vagarthgaurav/NanoPage/Case/previews/closed_back.png

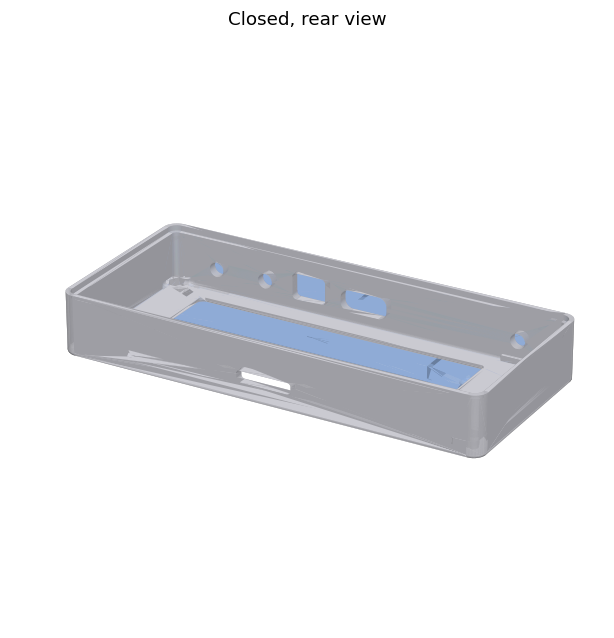
Case/previews/closed_back.png
