vagarthgaurav/NanoPage/Case/previews/closed_front.png

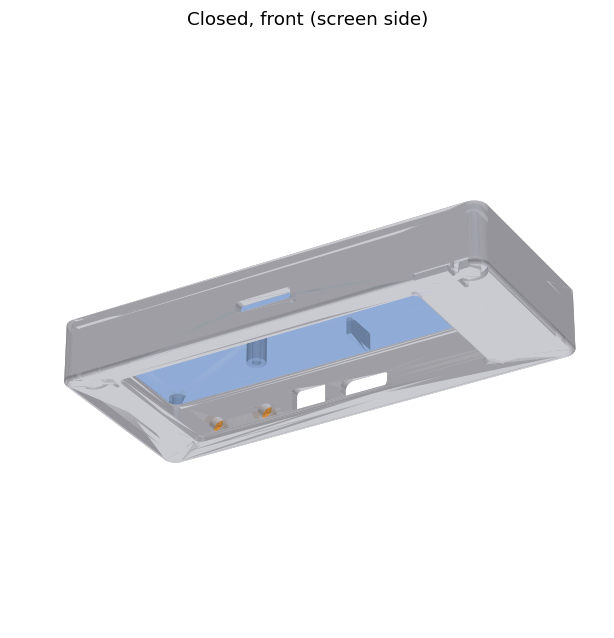
Case/previews/closed_front.png
