vagarthgaurav/NanoPage/Case/previews/inside.png

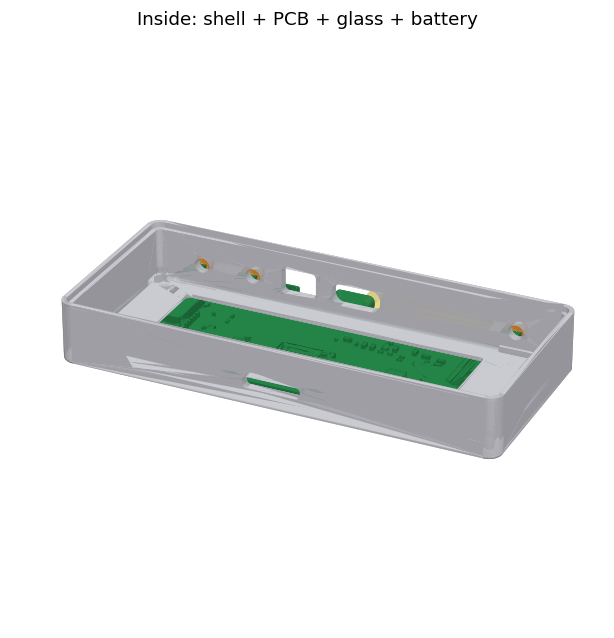
Case/previews/inside.png
