vagarthgaurav/NanoPage/Case/previews/shell_back.png

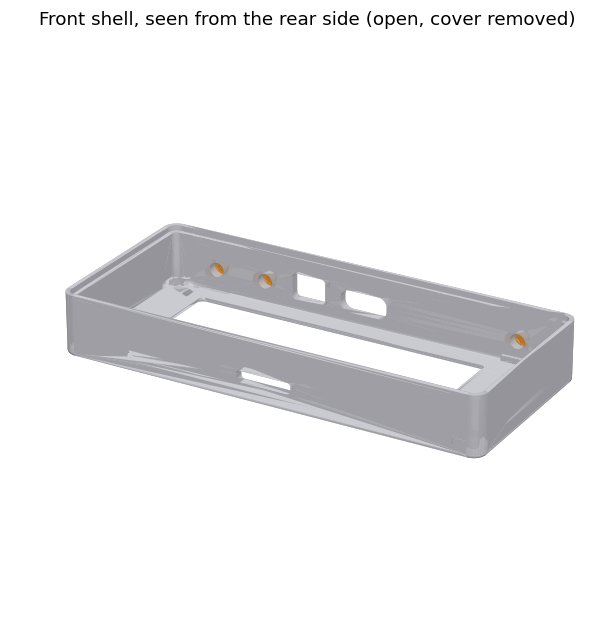
Case/previews/shell_back.png
