vagarthgaurav/NanoPage/Hardware/NanoPage/NanoPage.png

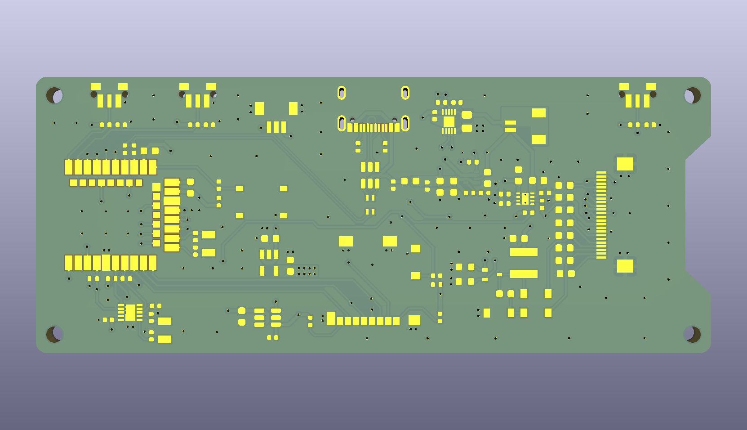
Hardware/NanoPage/NanoPage.png
