vagarthgaurav/NanoPage/Case/ref/nanopage_full.step

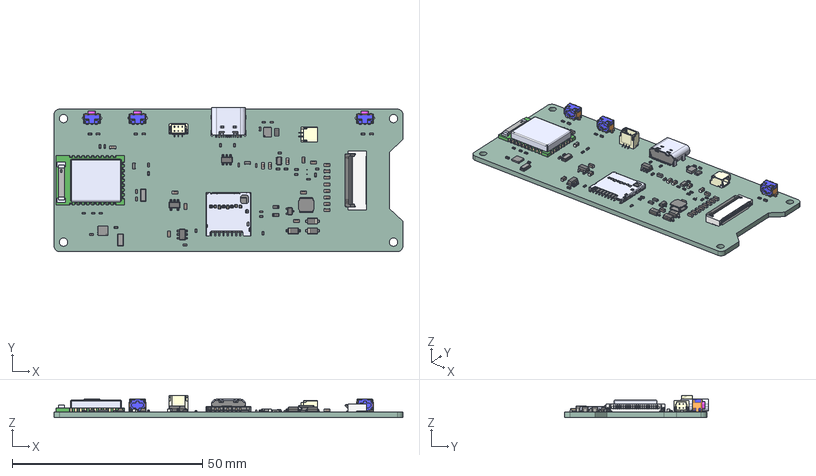
[picture p6: CAD file, 2026-10-15]
Case/ref/nanopage_full.step
91.8 x 38.0 x 5.90 mm
R_0402_1005Metric x 24
C_0402_1005Metric x 13
Crystal_SMD_3215-2Pin_3.2x1.5mm x 2
C_0603_1608Metric x 19
R_0805_2012Metric
E73-2G4M08S1C
D_SOD-123 x 3
ThermalPin x 2
PinsArrayLR x 2
FPC-05FB-24PH20
SM02B-SRSS-TB(LF)(SN)
SOT-323_SC-70
BM03B-SRSS-TB(LF)(SN)
NR4018
SOT-23-6 x 2
TPS2116DRLR
L_0603_1608Metric x 2
R_0603_1608Metric x 2
SOT-23-5
TYPE-C-31-M-12
NanoPage_PCB
