vagarthgaurav/NanoPage/Case/out/front_shell.step

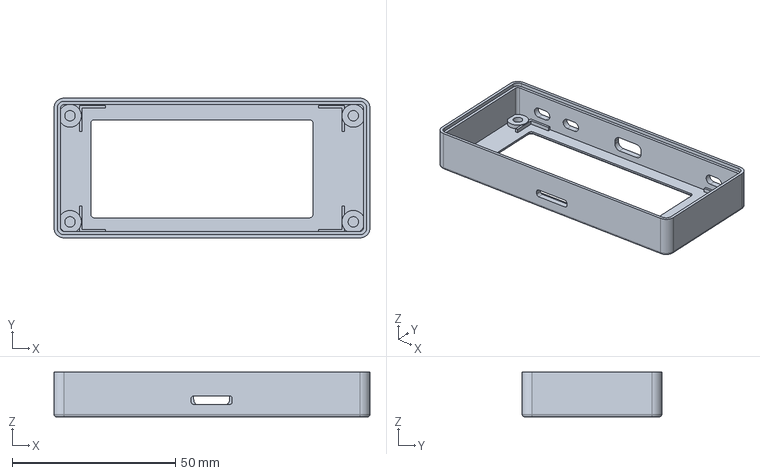
[picture p7: CAD file, 2026-10-15]
Case/out/front_shell.step
96.8 x 42.8 x 13.8 mm
