vagarthgaurav/NanoPage/Case/out/rear_cover.step

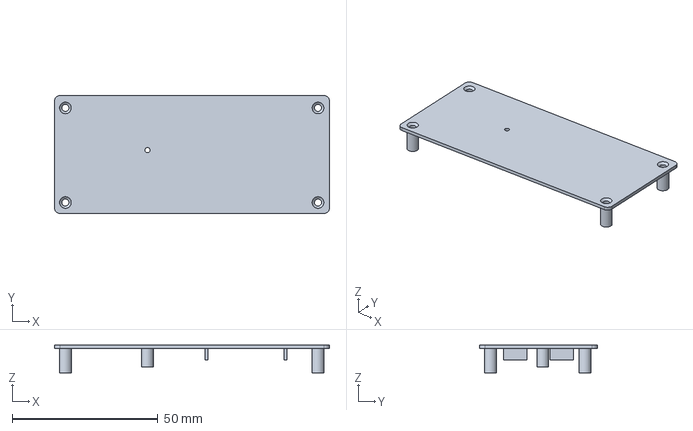
[picture p8: CAD file, 2026-10-15]
Case/out/rear_cover.step
94.5 x 40.5 x 9.53 mm
