vagarthgaurav/NanoPage/Case/out/button_cap.step

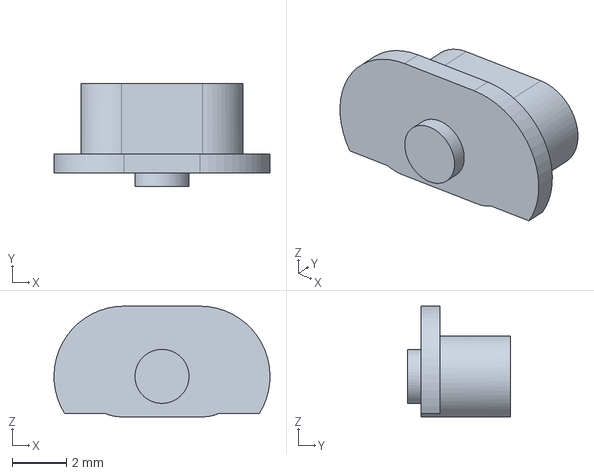
[picture p9: CAD file, 2026-10-15]
Case/out/button_cap.step
8.00 x 3.80 x 4.10 mm
