vagarthgaurav/NanoPage/Case/out/NanoPage_case.FCStd

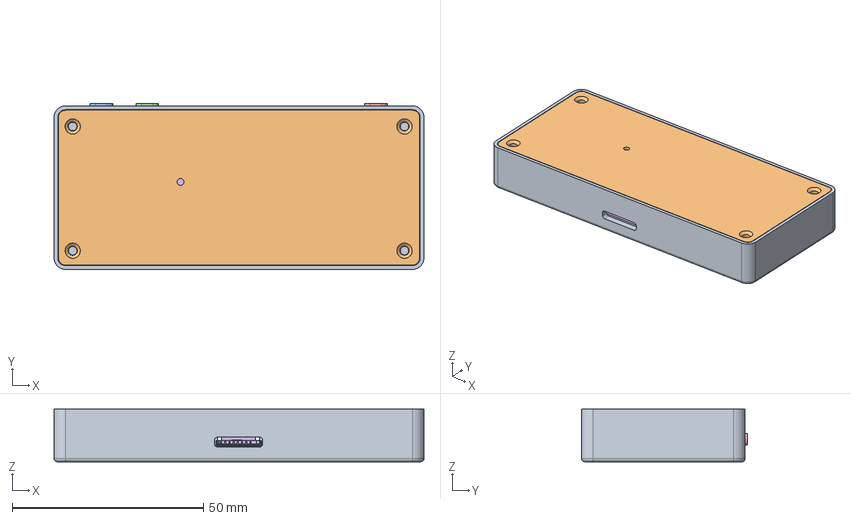
[picture p10: CAD file, 2026-10-15]
Case/out/NanoPage_case.FCStd
96.8 x 43.4 x 13.8 mm
front_shell
rear_cover
button_cap_1
button_cap_2
button_cap_3
ghost_PCB_assembly
ghost_display_glass
ghost_battery_box
ghost_FPC_corridor
