vagarthgaurav/NanoPage/(list of files, cad)

Other CAD files:
Case/out/button_cap.stl
Case/out/front_shell.stl
Case/out/rear_cover.stl
