vagarthgaurav/NanoPage/Hardware/NanoPage/NanoPage.kicad_pcb

## KiCad design Hardware/NanoPage/NanoPage.kicad_pcb (2026-10-14)

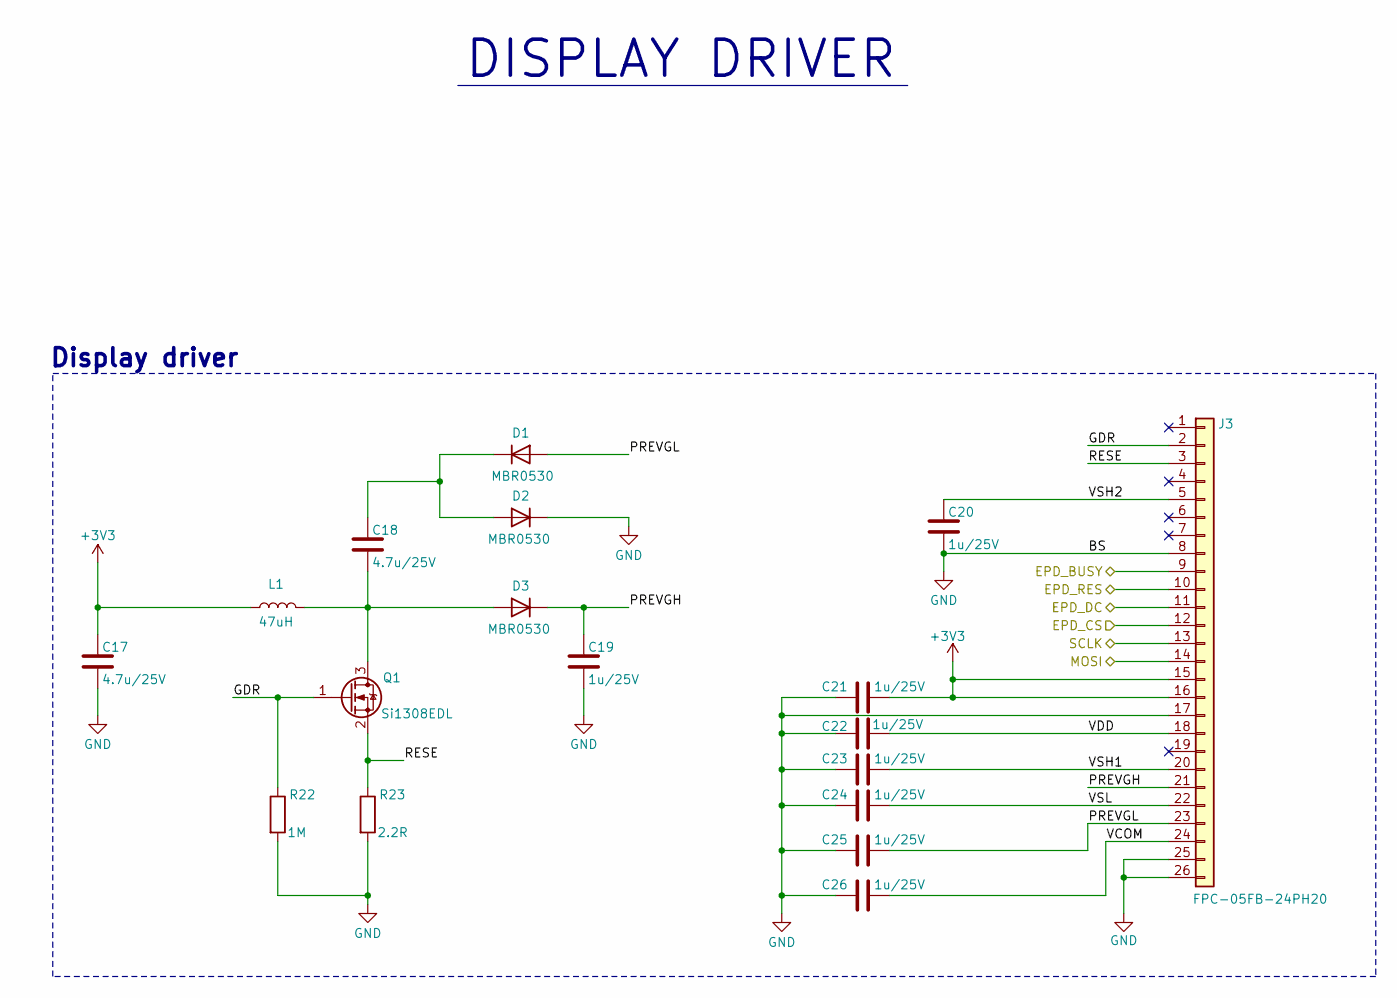
[picture p11: schematic display.kicad_sch]

Parts:
C17, C18: 4.7u/25V; C_0603_1608Metric
C19, C20, C21, C22, C23, C24, C25, C26: 1u/25V; C_0603_1608Metric
D1, D2, D3: MBR0530; D_SOD-123
J3: FPC-05FB-24PH20; XUNPU FPC-05FB-24PH20
L1: 47uH; NR4018
Q1: Si1308EDL; SOT-323_SC-70
R22: 1M; R_0603_1608Metric
R23: 2.2R; R_0603_1608Metric

Connections:
+3V3: C17.1, C21.2, J3.15, J3.16, L1.1; also elsewhere on the board
/Display/EPD_BUSY: J3.9; also elsewhere on the board
/Display/EPD_CS: J3.12; also elsewhere on the board
/Display/EPD_DC: J3.11; also elsewhere on the board
/Display/EPD_RES: J3.10; also elsewhere on the board
/Display/GDR: J3.2, Q1.1 (G), R22.1
/Display/MOSI: J3.14; also elsewhere on the board
/Display/PREVGH: C19.1, D3.1 (K), J3.21
/Display/PREVGL: C25.2, D1.2 (A), J3.23
/Display/RESE: J3.3, Q1.2 (S), R23.1
/Display/SCLK: J3.13; also elsewhere on the board
/Display/VCOM: C26.2, J3.24
/Display/VDD: C22.2, J3.18
/Display/VSH1: C23.2, J3.20
/Display/VSH2: C20.1, J3.5
/Display/VSL: C24.2, J3.22
GND: C17.2, C19.2, C20.2, C21.1, C22.1, C23.1, C24.1, C25.1, C26.1, D2.1 (K), J3.8, J3.17, J3.25, J3.26, R22.2, R23.2; also elsewhere on the board
unnamed: C18.1, D1.1 (K), D2.2 (A)
unnamed: C18.2, D3.2 (A), L1.2, Q1.3 (D)

Notes on the sheet:
Display driver
DISPLAY DRIVER

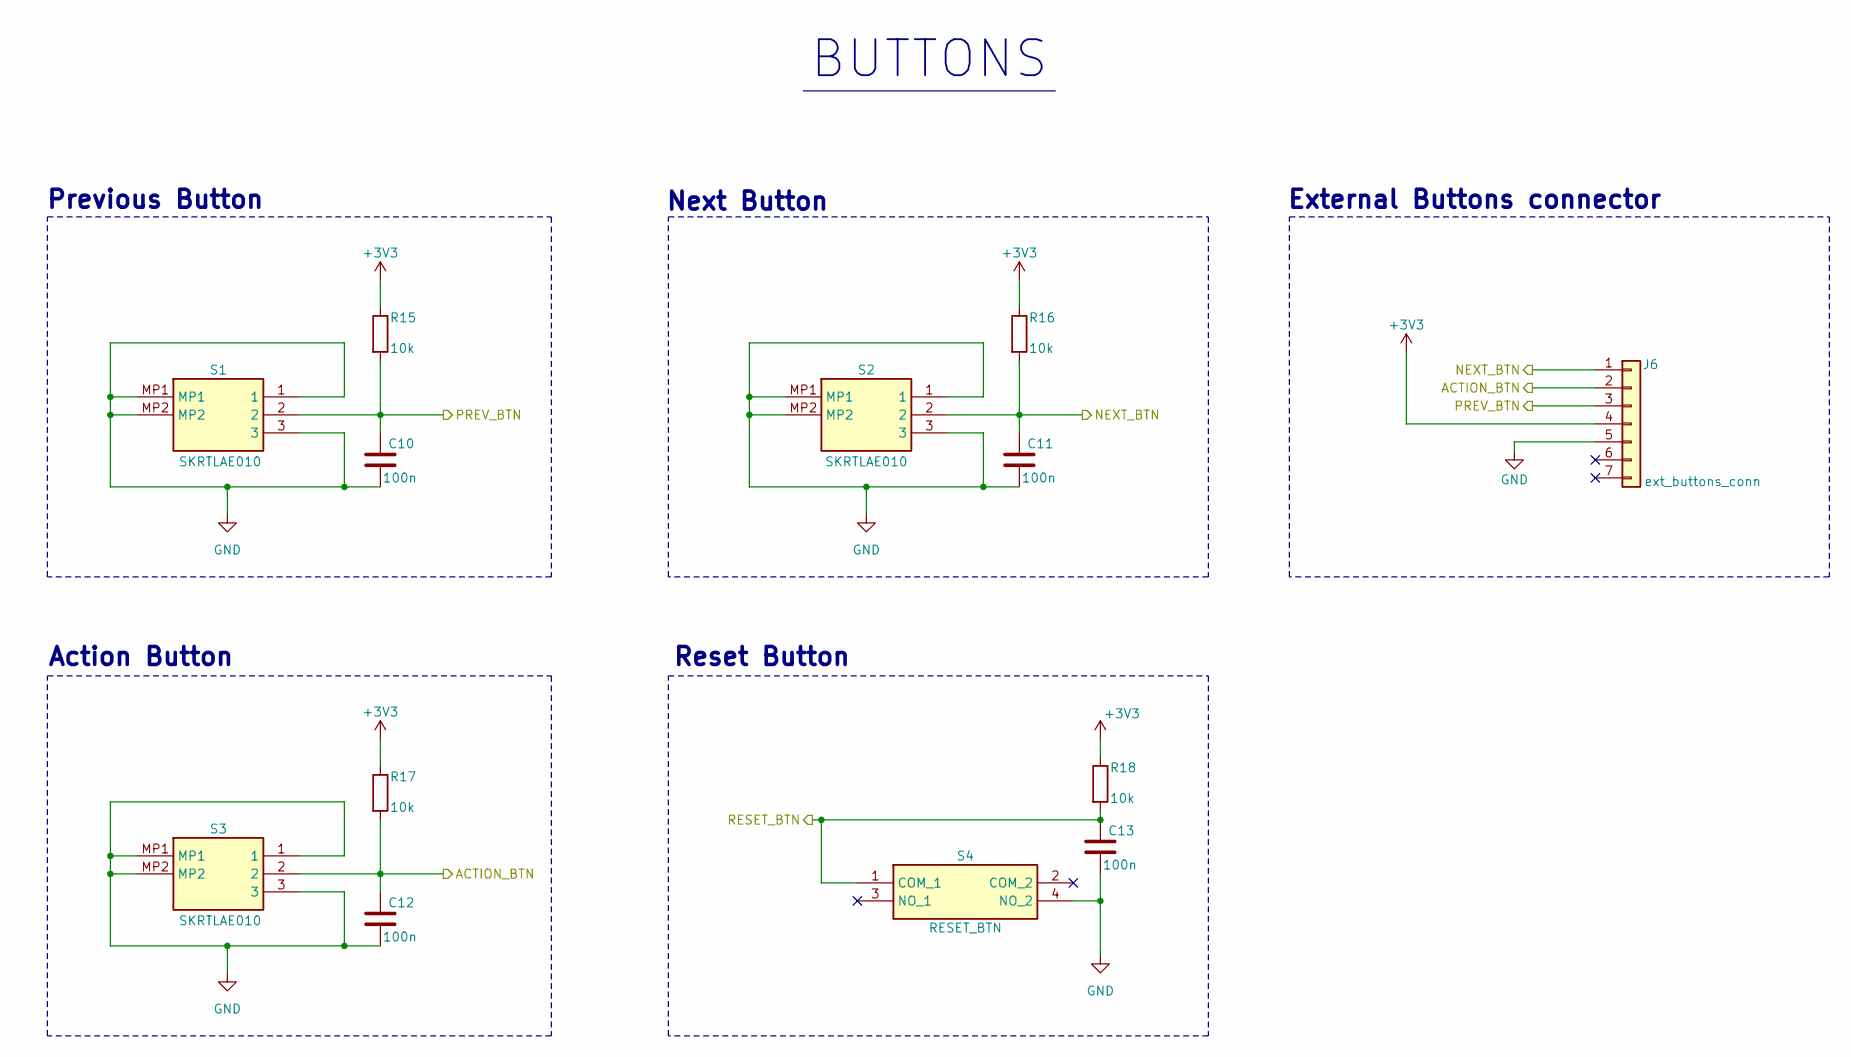
[picture p12: schematic buttons.kicad_sch]

Parts:
C10, C11, C12, C13: 100n; C_0402_1005Metric
J6: ext_buttons_conn; HC-FPC-05-09-5RLTAG
R15, R16, R17, R18: 10k; R_0402_1005Metric
S1, S2, S3: SKRTLAE010; Mouser Part Number 688-SKRTLA
S4: RESET_BTN; PTS526SM15SMTR2LFS; Mouser Part Number 611-PTS526SM15SMTR2L

Connections:
+3V3: J6.4, R15.1, R16.1, R17.1, R18.1; also elsewhere on the board
/Buttons/ACTION_BTN: C12.1, J6.2, R17.2, S3.2; also elsewhere on the board
/Buttons/NEXT_BTN: C11.1, J6.1, R16.2, S2.2; also elsewhere on the board
/Buttons/PREV_BTN: C10.1, J6.3, R15.2, S1.2; also elsewhere on the board
/Buttons/RESET_BTN: C13.1, R18.2, S4.1 (COM_1); also elsewhere on the board
GND: C10.2, C11.2, C12.2, C13.2, J6.5, S1.1, S1.3, S1.MP1, S1.MP2, S2.1, S2.3, S2.MP1, S2.MP2, S3.1, S3.3, S3.MP1, S3.MP2, S4.4 (NO_2); also elsewhere on the board

Notes on the sheet:
External Buttons connector
Reset Button
Action Button
BUTTONS
Next Button
Previous Button

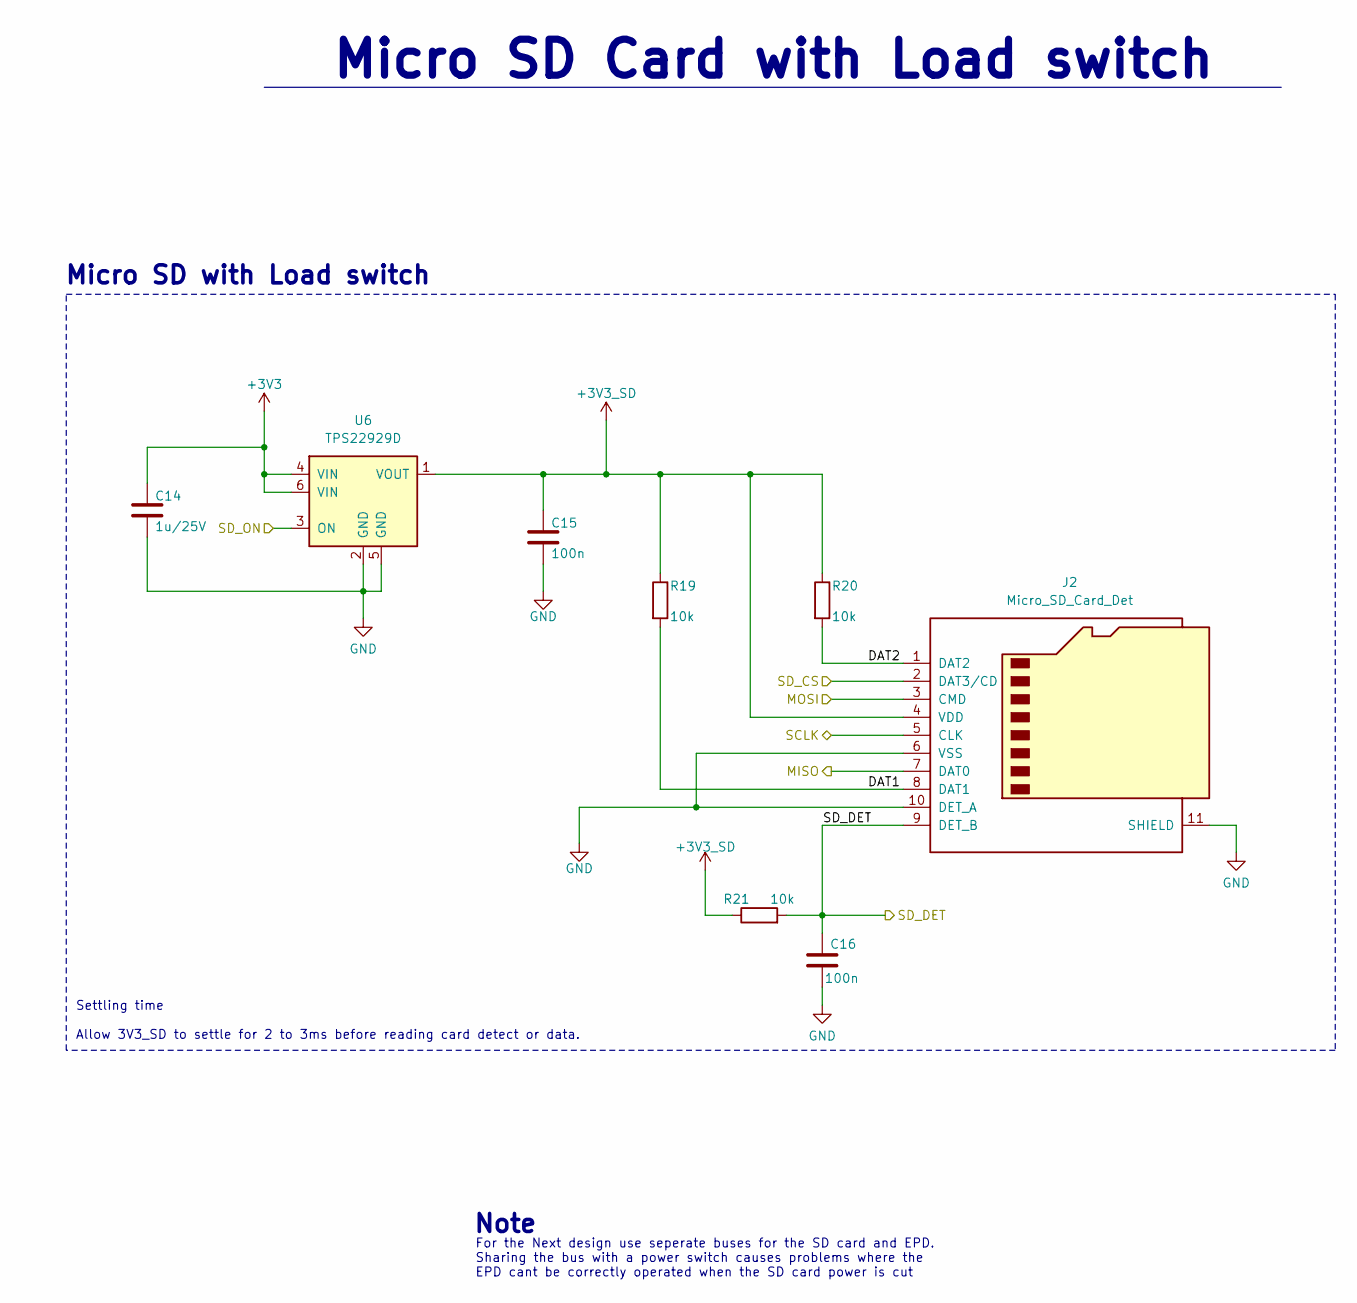
[picture p13: schematic sd_card.kicad_sch]

Parts:
C14: 1u/25V; C_0603_1608Metric
C15, C16: 100n; C_0402_1005Metric
J2: Micro_SD_Card_Det; microSD_HC_Molex_104031-0811
R19, R20, R21: 10k; R_0402_1005Metric
U6: TPS22929D; SOT-23-6

Connections:
+3V3: C14.1, U6.4 (VIN), U6.6 (VIN); also elsewhere on the board
+3V3_SD: C15.1, J2.4 (VDD), R19.1, R20.1, R21.1, U6.1 (VOUT)
/Display/MOSI: J2.3 (CMD); also elsewhere on the board
/Display/SCLK: J2.5 (CLK); also elsewhere on the board
/Microcontroller/MCU_SD_CS: J2.2 (DAT3/CD); also elsewhere on the board
/Microcontroller/MCU_SD_ON: U6.3 (ON); also elsewhere on the board
/Microcontroller/MISO: J2.7 (DAT0); also elsewhere on the board
/SD Card/DAT1: J2.8 (DAT1), R19.2
/SD Card/DAT2: J2.1 (DAT2), R20.2
/SD Card/SD_DET: C16.1, J2.9 (DET_B), R21.2; also elsewhere on the board
GND: C14.2, C15.2, C16.2, J2.6 (VSS), J2.10 (DET_A), J2.11 (SHIELD), U6.2 (GND), U6.5 (GND); also elsewhere on the board

Notes on the sheet:
Settling time Allow 3V3_SD to settle for 2 to 3ms before reading card detect or data.
For the Next design use seperate buses for the SD card and EPD. Sharing the bus with a power switch causes problems where the EPD cant be correctly operated when the SD card power is cut
Micro SD Card with Load switch
Note
Micro SD with Load switch

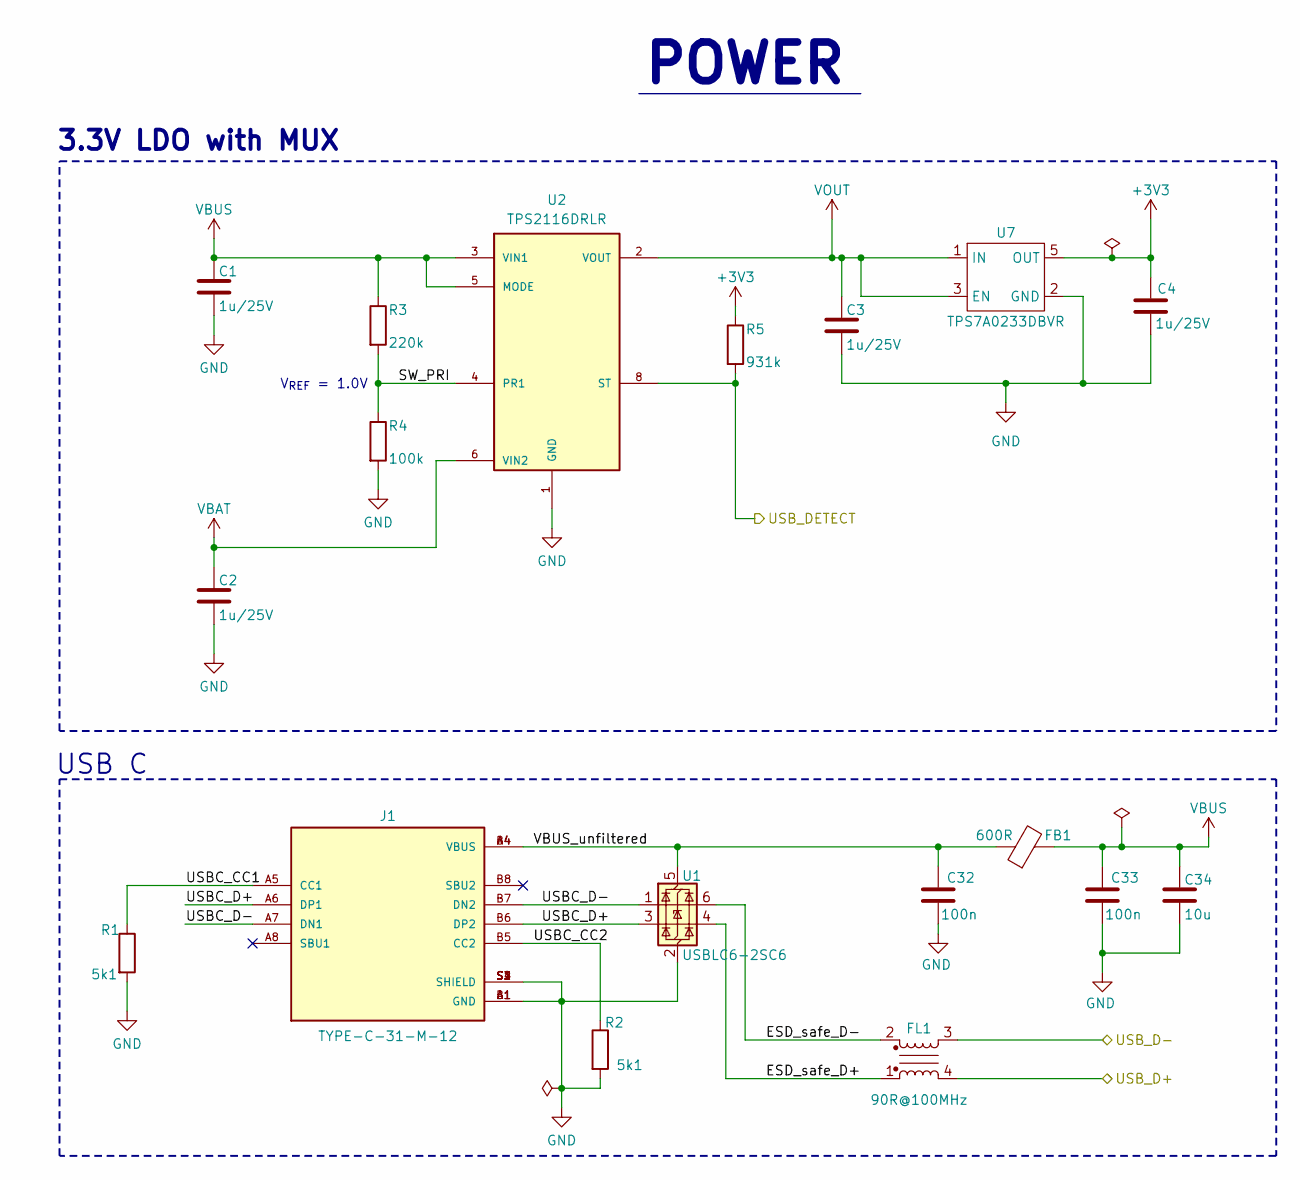
[picture p14: schematic power.kicad_sch]

Parts:
C1, C2, C3, C4: 1u/25V; C_0603_1608Metric
C32, C33: 100n; C_0402_1005Metric
C34: 10u; C_0603_1608Metric
FB1: 600R; L_0603_1608Metric
FL1: 90R@100MHz; L_CommonModeChoke_TDK_0503USB
J1: TYPE-C-31-M-12; HRO_TYPE-C-31-M-12; PARTREV 2020.12.08
R1, R2: 5k1; R_0402_1005Metric
R3: 220k; R_0402_1005Metric
R4: 100k; R_0402_1005Metric
R5: 931k; R_0402_1005Metric
U1: USBLC6-2SC6; SOT-23-6
U2: TPS2116DRLR; SOTFL50P160X60-8N; PARTREV A
U7: TPS7A0233DBVR; SOT-23-5

Connections:
+3V3: C4.1, R5.1, U7.5 (OUT); also elsewhere on the board
/Microcontroller/MCU_USB_D+: FL1.4; also elsewhere on the board
/Microcontroller/MCU_USB_D-: FL1.3; also elsewhere on the board
/Microcontroller/MCU_USB_DETECT: R5.2, U2.8 (ST); also elsewhere on the board
/Power/ESD_safe_D+: FL1.1, U1.4 (I/O2)
/Power/ESD_safe_D-: FL1.2, U1.6 (I/O1)
/Power/SW_PRI: R3.2, R4.1, U2.4 (PR1)
/Power/USBC_CC1: J1.A5 (CC1), R1.1
/Power/USBC_CC2: J1.B5 (CC2), R2.1
/Power/USBC_D+: J1.A6 (DP1), J1.B6 (DP2), U1.3 (I/O2)
/Power/USBC_D-: J1.A7 (DN1), J1.B7 (DN2), U1.1 (I/O1)
/Power/VBUS_unfiltered: C32.1, FB1.1, J1.A4 (VBUS), J1.B4 (VBUS), U1.5 (VBUS)
GND: C1.2, C2.2, C3.2, C4.2, C32.2, C33.2, C34.2, J1.A1 (GND), J1.B1 (GND), J1.S1 (SHIELD), J1.S2 (SHIELD), J1.S3 (SHIELD), J1.S4 (SHIELD), R1.2, R2.2, R4.2, U1.2 (GND), U2.1 (GND), U7.2 (GND); also elsewhere on the board
VBAT: C2.1, U2.6 (VIN2); also elsewhere on the board
VBUS: C1.1, C33.1, C34.1, FB1.2, R3.1, U2.3 (VIN1), U2.5 (MODE); also elsewhere on the board
VOUT: C3.1, U2.2 (VOUT), U2.7 (VOUT), U7.1 (IN), U7.3 (EN)

Notes on the sheet:
POWER
3.3V LDO with MUX
V_{REF} = 1.0V
USB C

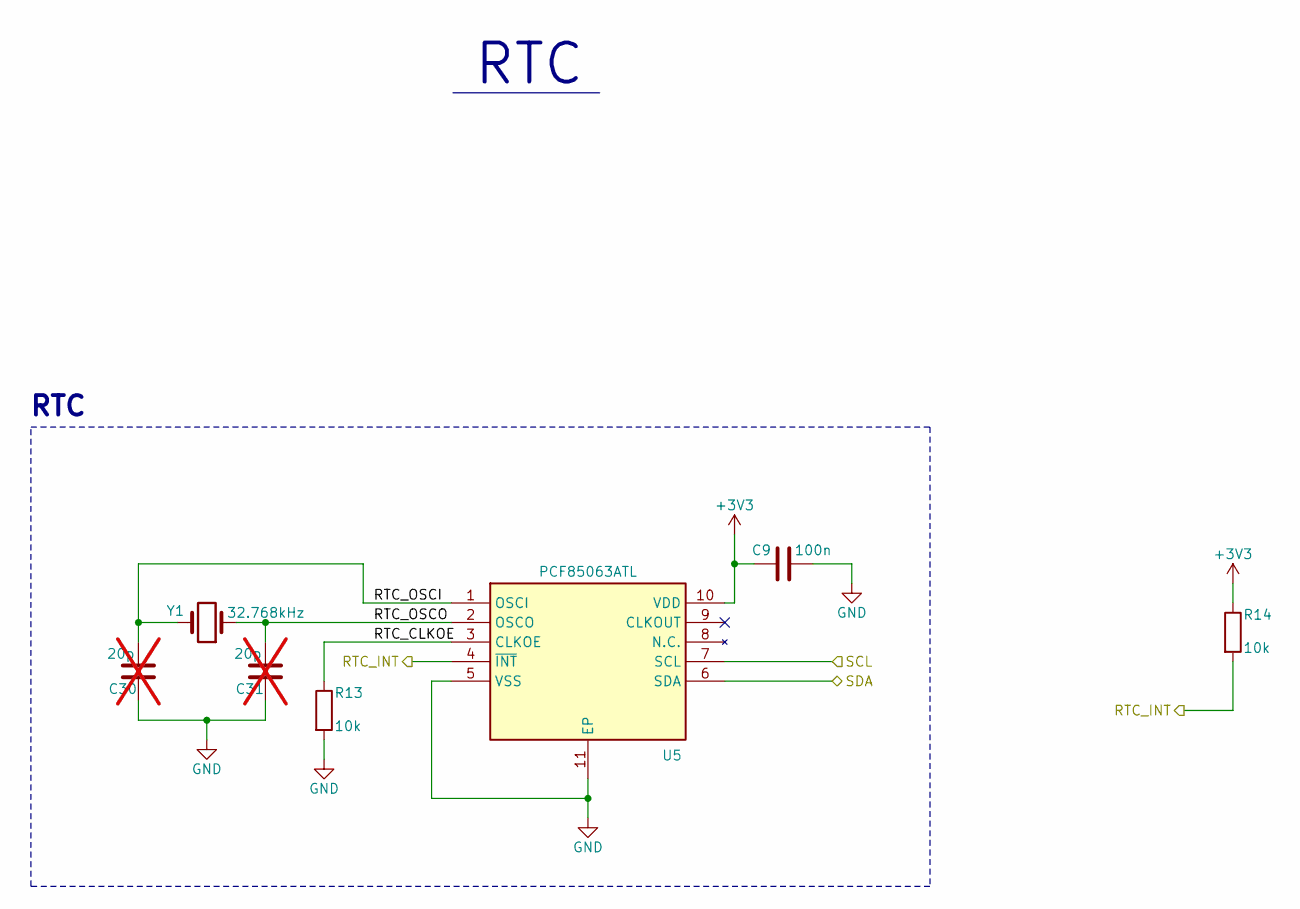
[picture p15: schematic rtc.kicad_sch, NanoPage]

Parts:
C9: 100n; C_0402_1005Metric
C30, C31: 20p; C_0402_1005Metric; not fitted
R13, R14: 10k; R_0402_1005Metric
U5: PCF85063ATL; SON50P260X260X50-11N; Mouser Part Number 771-PCF85063ATL1118
Y1: 32.768kHz; Crystal_SMD_3215-2Pin_3.2x1.5mm

Connections:
+3V3: C9.1, R14.1, U5.10 (VDD); also elsewhere on the board
/Battery Charger and Fuel Gauge/SCL: U5.7 (SCL); also elsewhere on the board
/Battery Charger and Fuel Gauge/SDA: U5.6 (SDA); also elsewhere on the board
/Microcontroller/MCU_RTC_INT: R14.2, U5.4 (~INT); also elsewhere on the board
/RTC/RTC_CLKOE: R13.1, U5.3 (CLKOE)
/RTC/RTC_OSCI: C30.2, U5.1 (OSCI), Y1.2
/RTC/RTC_OSCO: C31.2, U5.2 (OSCO), Y1.1
GND: C9.2, C30.1, C31.1, R13.2, U5.5 (VSS), U5.11 (EP); also elsewhere on the board

Notes on the sheet:
RTC

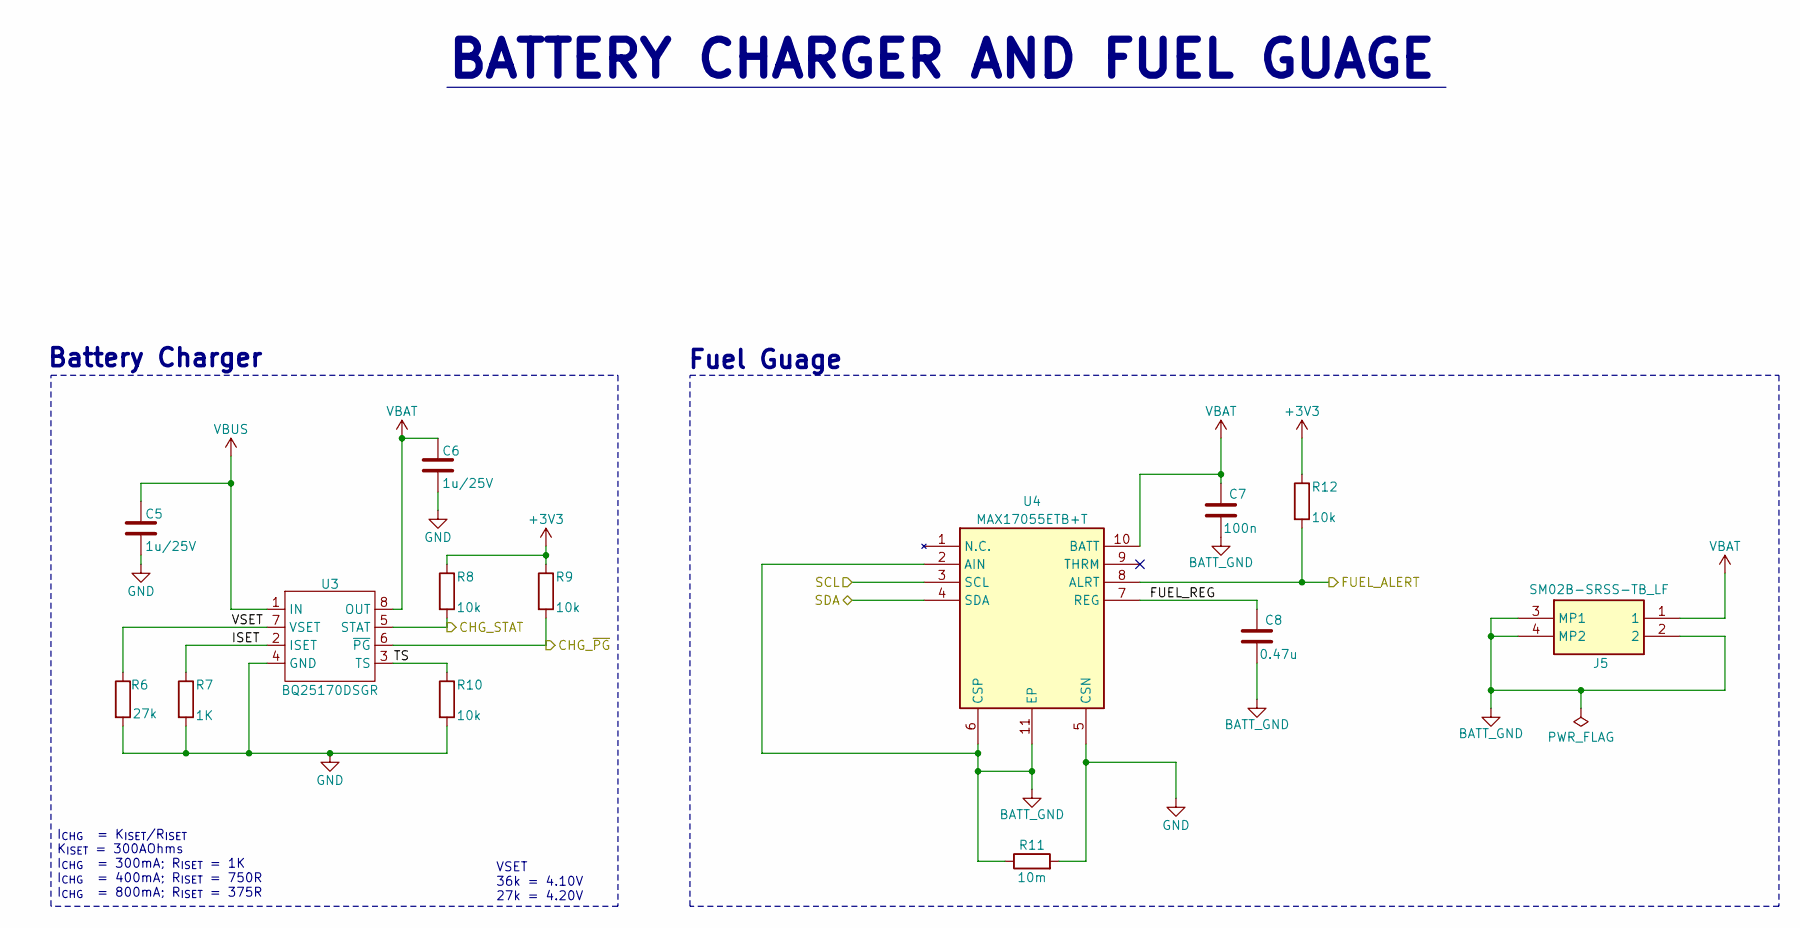
[picture p16: schematic battery_charger_and_fuel_guage.kicad_sch, NanoPage]

Parts:
C5, C6: 1u/25V; C_0603_1608Metric
C7: 100n; C_0402_1005Metric
C8: 0.47u; C_0402_1005Metric
J5: SM02B-SRSS-TB_LF; SM02BSRSSTBLFSN; Mouser Part Number N/A
R6: 27k; R_0402_1005Metric
R7: 1K; R_0402_1005Metric
R8, R9, R10, R12: 10k; R_0402_1005Metric
R11: 10m; R_0805_2012Metric
U3: BQ25170DSGR; BQ25170
U4: MAX17055ETB+T; SON40P250X200X80-11N; Mouser Part Number 700-MAX17055ETB+T

Connections:
+3V3: R8.1, R9.1, R12.1; also elsewhere on the board
/Battery Charger and Fuel Gauge/CHG_STAT: R8.2, U3.5 (STAT); also elsewhere on the board
/Battery Charger and Fuel Gauge/CHG_~PG: R9.2, U3.6 (~PG); also elsewhere on the board
/Battery Charger and Fuel Gauge/FUEL_ALERT: R12.2, U4.8 (ALRT); also elsewhere on the board
/Battery Charger and Fuel Gauge/FUEL_REG: C8.1, U4.7 (REG)
/Battery Charger and Fuel Gauge/ISET: R7.1, U3.2 (ISET)
/Battery Charger and Fuel Gauge/SCL: U4.3 (SCL); also elsewhere on the board
/Battery Charger and Fuel Gauge/SDA: U4.4 (SDA); also elsewhere on the board
/Battery Charger and Fuel Gauge/TS: R10.1, U3.3 (TS)
/Battery Charger and Fuel Gauge/VSET: R6.1, U3.7 (VSET)
BATT_GND: C7.2, C8.2, J5.2, J5.3 (MP1), J5.4 (MP2), R11.1, U4.2 (AIN), U4.6 (CSP), U4.11 (EP)
GND: C5.2, C6.2, R6.2, R7.2, R10.2, R11.2, U3.4 (GND), U3.9 (PAD), U4.5 (CSN); also elsewhere on the board
VBAT: C6.1, C7.1, J5.1, U3.8 (OUT), U4.10 (BATT); also elsewhere on the board
VBUS: C5.1, U3.1 (IN); also elsewhere on the board

Notes on the sheet:
Fuel Guage
I_{CHG} = K_{ISET}/R_{ISET} K_{ISET} = 300AOhms I_{CHG} = 300mA; R_{ISET} = 1K I_{CHG} = 400mA; R_{ISET} = 750R I_{CHG} = 800mA; R_{ISET} = 375R
Battery Charger
BATTERY CHARGER AND FUEL GUAGE
VSET 36k = 4.10V 27k = 4.20V

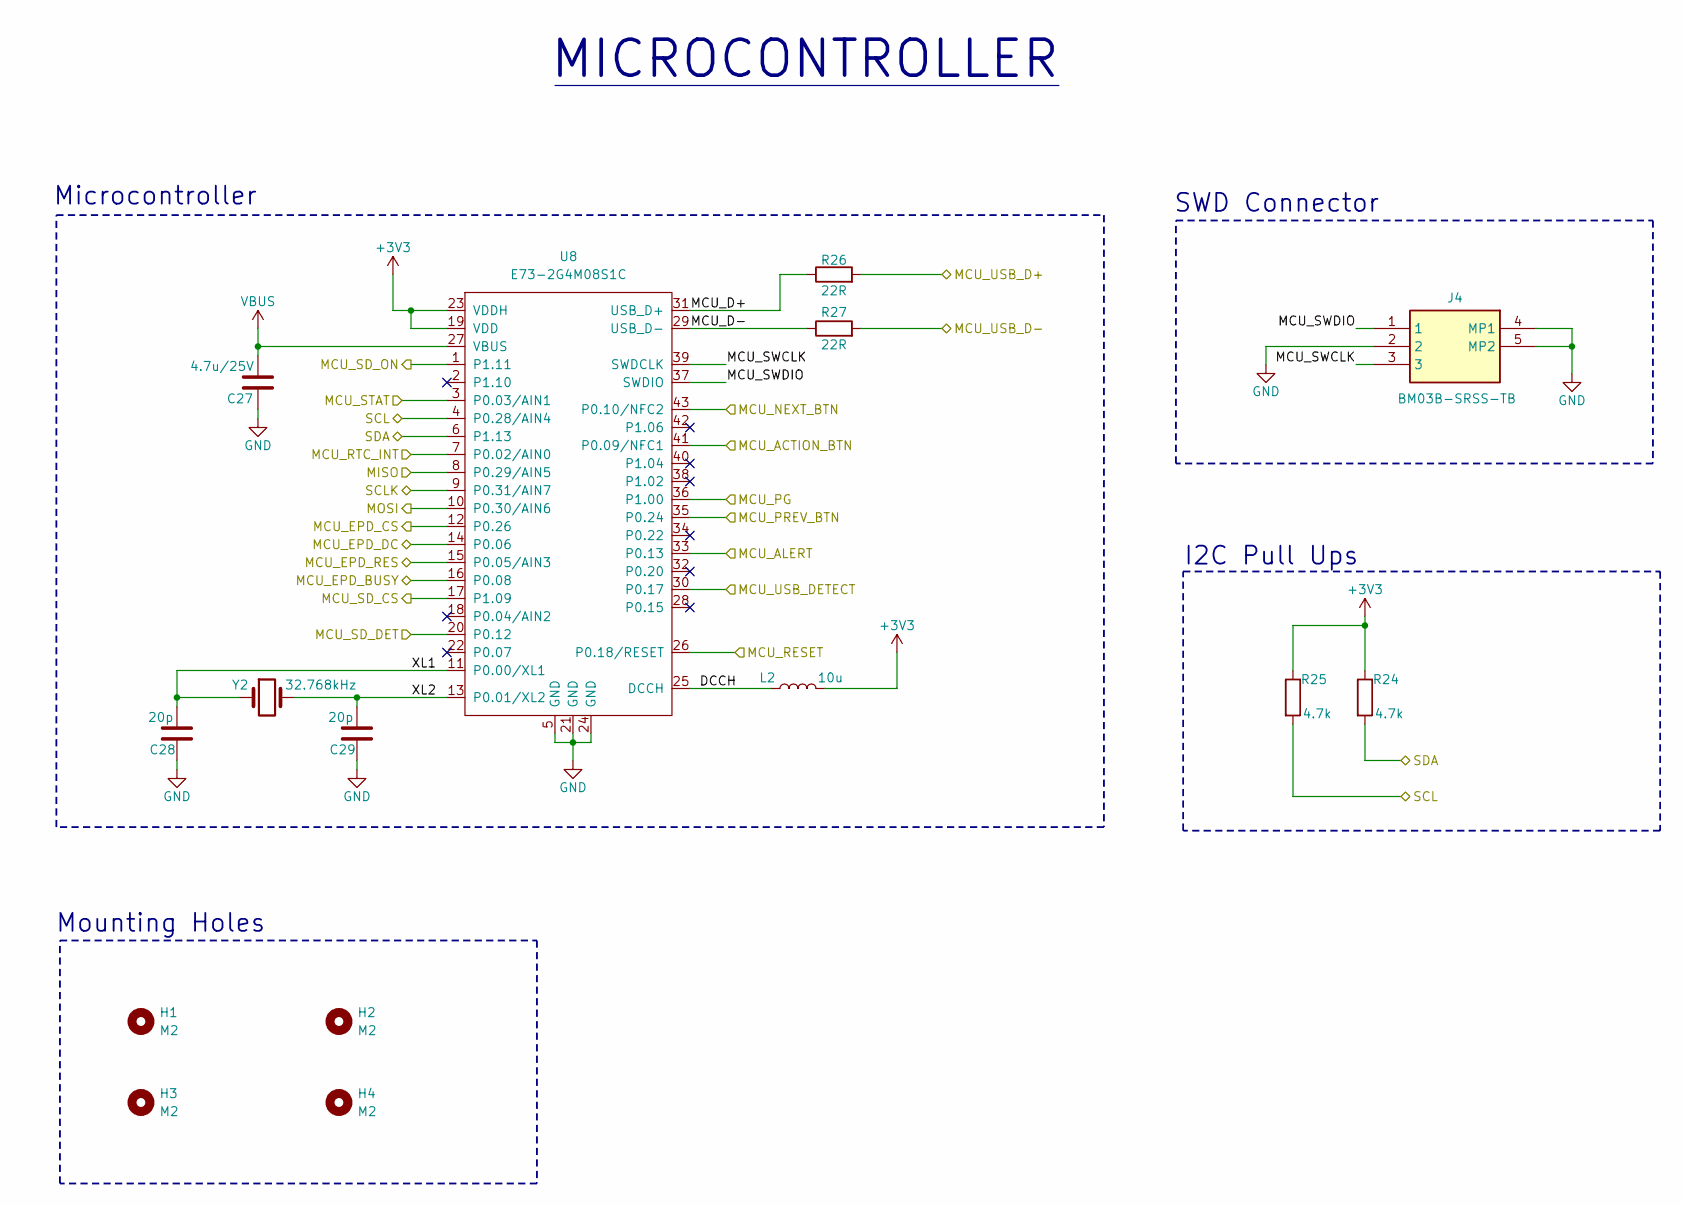
[picture p17: schematic mcu.kicad_sch]

Parts:
C27: 4.7u/25V; C_0603_1608Metric
C28, C29: 20p; C_0402_1005Metric
H1, H2, H3, H4: M2; MountingHole_2.2mm_M2_DIN965
J4: BM03B-SRSS-TB; BM03BSRSSTBLFSN; Mouser Part Number 306-BM03BSRSSTBLFSNP
L2: 10u; L_0603_1608Metric
R24, R25: 4.7k; R_0402_1005Metric
R26, R27: 22R; R_0402_1005Metric
U8: E73-2G4M08S1C
Y2: 32.768kHz; Crystal_SMD_3215-2Pin_3.2x1.5mm

Connections:
+3V3: L2.2, R24.1, R25.1, U8.19 (VDD), U8.23 (VDDH); also elsewhere on the board
/Battery Charger and Fuel Gauge/CHG_STAT: U8.3 (P0.03/AIN1); also elsewhere on the board
/Battery Charger and Fuel Gauge/CHG_~PG: U8.36 (P1.00); also elsewhere on the board
/Battery Charger and Fuel Gauge/FUEL_ALERT: U8.33 (P0.13); also elsewhere on the board
/Battery Charger and Fuel Gauge/SCL: R25.2, U8.4 (P0.28/AIN4); also elsewhere on the board
/Battery Charger and Fuel Gauge/SDA: R24.2, U8.6 (P1.13); also elsewhere on the board
/Buttons/ACTION_BTN: U8.41 (P0.09/NFC1); also elsewhere on the board
/Buttons/NEXT_BTN: U8.43 (P0.10/NFC2); also elsewhere on the board
/Buttons/PREV_BTN: U8.35 (P0.24); also elsewhere on the board
/Buttons/RESET_BTN: U8.26 (P0.18/RESET); also elsewhere on the board
/Display/EPD_BUSY: U8.16 (P0.08); also elsewhere on the board
/Display/EPD_CS: U8.12 (P0.26); also elsewhere on the board
/Display/EPD_DC: U8.14 (P0.06); also elsewhere on the board
/Display/EPD_RES: U8.15 (P0.05/AIN3); also elsewhere on the board
/Display/MOSI: U8.10 (P0.30/AIN6); also elsewhere on the board
/Display/SCLK: U8.9 (P0.31/AIN7); also elsewhere on the board
/Microcontroller/DCCH: L2.1, U8.25 (DCCH)
/Microcontroller/MCU_D+: R26.1, U8.31 (USB_D+)
/Microcontroller/MCU_D-: R27.1, U8.29 (USB_D-)
/Microcontroller/MCU_RTC_INT: U8.7 (P0.02/AIN0); also elsewhere on the board
/Microcontroller/MCU_SD_CS: U8.17 (P1.09); also elsewhere on the board
/Microcontroller/MCU_SD_ON: U8.1 (P1.11); also elsewhere on the board
/Microcontroller/MCU_SWCLK: J4.3, U8.39 (SWDCLK)
/Microcontroller/MCU_SWDIO: J4.1, U8.37 (SWDIO)
/Microcontroller/MCU_USB_D+: R26.2; also elsewhere on the board
/Microcontroller/MCU_USB_D-: R27.2; also elsewhere on the board
/Microcontroller/MCU_USB_DETECT: U8.30 (P0.17); also elsewhere on the board
/Microcontroller/MISO: U8.8 (P0.29/AIN5); also elsewhere on the board
/Microcontroller/XL1: C28.2, U8.11 (P0.00/XL1), Y2.1
/Microcontroller/XL2: C29.2, U8.13 (P0.01/XL2), Y2.2
/SD Card/SD_DET: U8.20 (P0.12); also elsewhere on the board
GND: C27.1, C28.1, C29.1, J4.2, J4.4 (MP1), J4.5 (MP2), U8.5 (GND), U8.21 (GND), U8.24 (GND); also elsewhere on the board
VBUS: C27.2, U8.27 (VBUS); also elsewhere on the board

Notes on the sheet:
Microcontroller
SWD Connector
Mounting Holes
MICROCONTROLLER
I2C Pull Ups

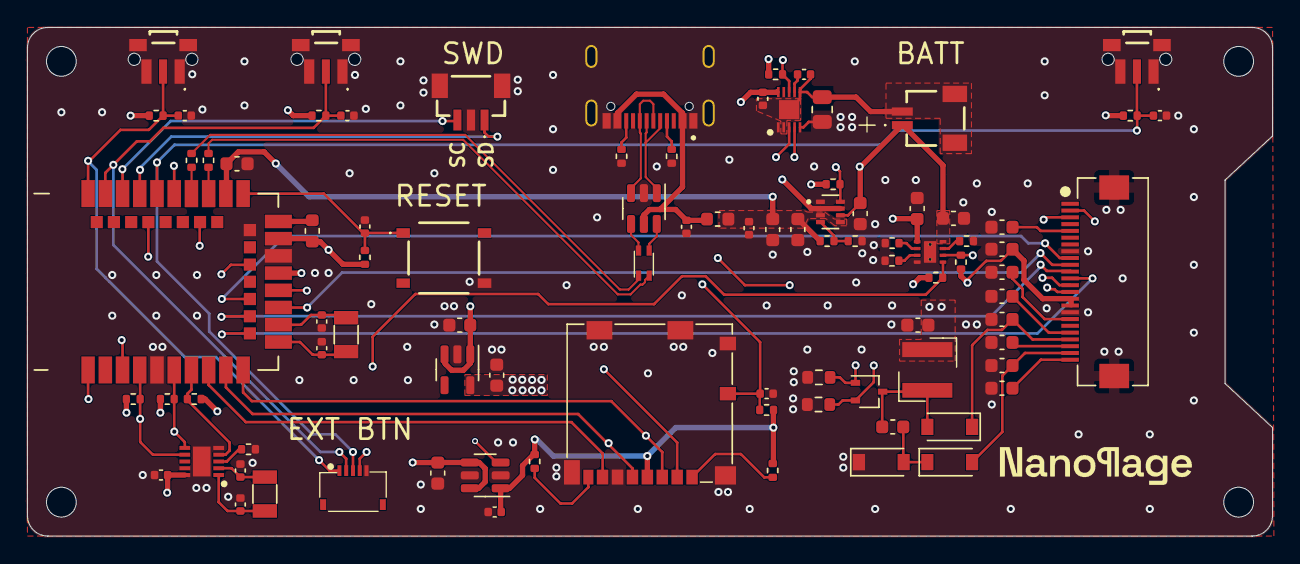
[picture p18: board NanoPage.kicad_pcb from above]

Board: 6 copper layers, 91.8 x 37.5 mm, 93 parts (0 on the bottom side), 65 nets.
