vagarthgaurav/NanoPage/Firmware/src/display/logo_nanopage.c

/* SPDX-License-Identifier: Apache-2.0 */

#include "logo_nanopage.h"

const uint8_t app_logo_nanopage[APP_LOGO_NANOPAGE_WIDTH * APP_LOGO_NANOPAGE_HEIGHT / 8] = {
	0x80, 0x80, 0x8f, 0x80, 0xf0, 0xff, 0x80, 0x80, 0xff, 0xff, 0xfb, 0xf2, 0xf6, 0xf6, 0xf0, 0xf8,
	0xff, 0xff, 0xf0, 0xf0, 0xfb, 0xf3, 0xf3, 0xf1, 0xf8, 0xff, 0xff, 0xf8, 0xf0, 0xf3, 0xf3, 0xf3,
	0xf3, 0xf8, 0xfc, 0xc3, 0xc1, 0x9d, 0xbd, 0x80, 0x9f, 0x80, 0x80, 0xff, 0xff, 0xfa, 0xf2, 0xf2,
	0xf2, 0xf0, 0xf8, 0xff, 0xff, 0xf8, 0xf0, 0xf3, 0xf3, 0xf3, 0xf3, 0xf0, 0xf0, 0xff, 0xfc, 0xf8,
	0xf0, 0xf2, 0xf2, 0xf2, 0xf8, 0xfc, 0x0f, 0x0f, 0xff, 0x7f, 0x1f, 0x8f, 0x0f, 0x0f, 0xff, 0x9f,
	0x0f, 0x4f, 0x4f, 0x4f, 0x1f, 0x0f, 0xcf, 0xff, 0x0f, 0x0f, 0xff, 0xff, 0xff, 0xff, 0x0f, 0xff,
	0xff, 0x3f, 0x1f, 0xcf, 0xcf, 0xcf, 0xcf, 0x1f, 0x3f, 0xff, 0xff, 0xff, 0xff, 0x0f, 0xff, 0x1f,
	0x0f, 0xff, 0x3f, 0x0f, 0x4f, 0x4f, 0x4f, 0x1f, 0x0f, 0xcf, 0xff, 0x3f, 0x19, 0xc9, 0xc9, 0xc9,
	0x99, 0x01, 0x01, 0xff, 0x3f, 0x1f, 0x8f, 0xcf, 0xcf, 0xcf, 0x9f, 0xdf,
};
