vagarthgaurav/NanoPage/Firmware/nanopage-firmware/include/FuelGauge.h

// MAX17055 fuel gauge (I2C 0x36). Register access ported from peripheral_test/src/main.cpp.

#pragma once

#include <Arduino.h>
#include <Wire.h>

class FuelGauge
{
public:
    explicit FuelGauge(TwoWire &wire = Wire) : wire_(wire) {}

    // What the chip has learned about this specific cell so far - lives only in its
    // registers and is forgotten if it ever loses power (e.g. battery unplugged).
    // Plain aggregate (no default member initializers) so it stays constexpr-brace-
    // initializable in the C++ dialect this toolchain builds with.
    struct LearnedParams
    {
        uint16_t rcomp0;
        uint16_t tempCo;
        uint16_t fullCapNom;
        uint16_t fullCapRep;
        uint16_t cycles;
    };

    // A real POR (lost power) always gets a full EZ-Config model load - that's what
    // makes the chip (re)compute a valid MixSOC from the current cell voltage. If
    // `saved` is non-null, those learned parameters are then layered on top of
    // that fresh model instead of starting from its generic hardware defaults.
    bool begin(const LearnedParams *saved = nullptr);

    bool present() const { return present_; }

    float percent(); // state of charge, 0..100
    float voltageMilliVolts();
    float currentMilliAmps();

    // Snapshot the model's current learned state, for persisting outside the chip.
    LearnedParams learnedParams();

    // Clears the 1% SOC change alert flag (STATUS.dSOCi) after servicing it - the
    // ALRT pin (open-drain) stays asserted low until this is done.
    void clearSocChangeAlert();

    // One-shot Serial dump of the EZ-Config/model registers, for comparing against
    // the datasheet's expected values when SOC doesn't track real battery state.
    // Caller is responsible for gating this on Config::DEBUG_SERIAL.
    void debugDumpRegisters();

    // Forces a full, fresh EZ-Config re-init right now (fakes the chip's own POR
    // flag so runEzConfigIfNeeded() proceeds), then optionally overlays `ref`'s
    // learned params on top - equivalent to what a real battery-disconnect event
    // followed by a saved-seed restore would do, but triggered on demand. Needed
    // because restoreLearnedParams() alone assumes MixSOC was *just* freshly and
    // validly recomputed by a real POR - calling it on an already-running chip
    // with a corrupted MixSOC just carries that corruption into the new MixCap.
    void forceFullReinit(const LearnedParams *ref);

    // Sanity check for a LearnedParams snapshot (e.g. one loaded back from flash)
    // - rejects capacity values wildly outside what's plausible for this board's
    // pack, so a corrupted snapshot can't get faithfully restored forever. This
    // exact failure mode (a ~4x phantom capacity persisting indefinitely once
    // saved) is what caused most of this saga - see
    // project_fuelgauge_ez_config_calibration memory.
    static bool learnedParamsPlausible(const LearnedParams &p);

    // Board has a generic 2-pin JST connector - must match whatever pack is fitted.
    static constexpr float DESIGN_CAPACITY_MAH = 320.0f;
    static constexpr uint16_t VEMPTY_MV = 3300;
    static constexpr uint16_t VRECOVERY_MV = 3880;

private:
    static constexpr uint8_t ADDR = 0x36;
    static constexpr uint8_t REG_STATUS = 0x00;    // bit1 = POR, bit7 = dSOCi (1% SOC change alert)
    static constexpr uint8_t REG_CONFIG = 0x1D;    // bit2 = Aen (enable ALRT pin output)
    static constexpr uint8_t REG_REPSOC = 0x06;    // 1/256 %/LSB
    static constexpr uint8_t REG_VCELL = 0x09;     // 78.125uV/LSB
    static constexpr uint8_t REG_CURRENT = 0x0A;   // signed, 1.5625uV/RSENSE per LSB
    static constexpr uint8_t REG_MIXSOC = 0x0D;     // used only to recompute MixCap on restore
    static constexpr uint8_t REG_MIXCAP = 0x0F;     // same LSB as DesignCap
    static constexpr uint8_t REG_FULLCAPREP = 0x10; // same LSB as DesignCap
    static constexpr uint8_t REG_CYCLES = 0x17;     // 1%/LSB of a full cycle
    static constexpr uint8_t REG_DESIGNCAP = 0x18;  // 5.0uVh/RSENSE per LSB
    static constexpr uint8_t REG_FULLCAPNOM = 0x23; // same LSB as DesignCap
    static constexpr uint8_t REG_ICHGTERM = 0x1E; // same LSB as Current
    static constexpr uint8_t REG_RCOMP0 = 0x38;
    static constexpr uint8_t REG_TEMPCO = 0x39;
    static constexpr uint8_t REG_VEMPTY = 0x3A;
    static constexpr uint8_t REG_MODELCFG = 0xDB;
    static constexpr uint8_t REG_FSTAT = 0x3D; // bit0 = DNR
    static constexpr uint8_t REG_DQACC = 0x45;
    static constexpr uint8_t REG_DPACC = 0x46;
    static constexpr uint8_t REG_HIBCFG = 0xBA;
    static constexpr uint8_t REG_COMMAND = 0x60;
    static constexpr uint8_t REG_CONFIG2 = 0xBB;   // bit7 = dSOCen (enable 1% SOC change alert)

    static constexpr uint16_t CONFIG_AEN = 0x0004;      // CONFIG bit2
    static constexpr uint16_t CONFIG2_DSOCEN = 0x0080;  // CONFIG2 bit7
    static constexpr uint16_t STATUS_DSOCI = 0x0080;    // STATUS bit7

    static constexpr float RSENSE_OHMS = 0.010f; // current-sense resistor on CSP/CSN
    static constexpr float CURRENT_MA_PER_LSB = 1.5625f / RSENSE_OHMS / 1000.0f;
    static constexpr float CAPACITY_MAH_PER_LSB = 5.0f / (RSENSE_OHMS * 1000.0f);

    bool readReg(uint8_t reg, uint16_t &out);
    bool writeReg(uint8_t reg, uint16_t value);
    // Write, then read back and retry (up to 3 attempts total) until it matches -
    // required by UG6365 for registers the ModelGauge algorithm updates on its own
    // (FullCapRep, MixCap, etc.), since a plain write can lose a race against the
    // chip's own internal write and get silently dropped. Used throughout
    // restoreLearnedParams() per the datasheet's own restore procedure (4.5-4.11).
    bool writeAndVerifyReg(uint8_t reg, uint16_t value);
    // Converts one raw register value into an engineering-units string for
    // debugDumpRegisters() - RCOMP0/TempCo have no clean physical unit, so
    // those print as plain calibration coefficients.
    String decodeRegister(uint8_t reg, uint16_t raw);
    // Writes DesignCap/IChgTerm/VEmpty from this board's fixed pack spec (not
    // learned per-chip state) - called unconditionally from begin() since
    // restoreLearnedParams() deliberately doesn't touch these three.
    void writeCapacityConfig();
    void runEzConfigIfNeeded();
    void restoreLearnedParams(const LearnedParams &saved);
    void waitForPorRoutineDone(); // FSTAT.DNR - shared by EZ Config and restore
    void enableSocChangeAlert();  // sets CONFIG.Aen + CONFIG2.dSOCen - called once from begin()

    TwoWire &wire_;
    bool present_ = false;
};
