vagarthgaurav/NanoPage/Firmware/src/storage/sd.h

/* SPDX-License-Identifier: Apache-2.0 */

#ifndef APP_SD_H_
#define APP_SD_H_

#include <stdbool.h>
#include <stddef.h>
#include <stdint.h>

#define APP_SD_DISK_NAME "SD"

int app_sd_init(void);

void app_sd_deinit(void);

int app_sd_usb_claim(void);

void app_sd_usb_release(void);

int app_sd_power_on(void);
void app_sd_power_off(void);

#define APP_SD_MAX_PATH_LEN 200

#define APP_SD_MAX_NAME_LEN 48

struct app_sd_dirent {
	char name[APP_SD_MAX_NAME_LEN];
	bool is_dir;
};

int app_sd_list_dir(const char *path, struct app_sd_dirent *entries, size_t max_entries,
		     size_t *count);

/* Free and total space in KiB, clamped below UINT32_MAX. Needs app_sd_init();
 * -ENODEV if the card is not mounted.
 */
int app_sd_get_usage(uint32_t *free_kb, uint32_t *total_kb);

int app_sd_full_path(const char *path, char *out, size_t out_size);

#endif /* APP_SD_H_ */
