vagarthgaurav/NanoPage/(commit log)

2026-05-29 feat: Final board layout
2026-08-05 fix: Fix wrong footprint
2026-08-18 feat: Add an external button connector and fix some issues
2026-09-04 fix: Update resistor value
2026-09-04 chore: Ignore local KiCad history cache
2026-09-04 feat: Add Adafruit nRF52 bootloader submodule with nanopage board support
2026-09-05 feat: Add microSD and BLE central scan to peripheral test
    Mounts the microSD card and lists the first 5 root directory entries,
    and starts a background BLE central scan that caches the first 3
    nearby devices that actually advertise a name. Both are drawn as
    side-by-side columns on the e-paper panel in place of the old Chg/USB
    lines (still logged to Serial every redraw, just no longer drawn).
    Also defines LED_BUILTIN/LED_BLUE in the nanopage variant, pointed
    past PINS_COUNT so they're safe no-ops: including bluefruit.h pulls in
    Adafruit's InternalFileSystem (BLE bond storage) and Bluefruit's own
    connection-LED blink, both of which reference those macros
    unconditionally even though this LED-l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
2026-09-05 feat: Add nanopage-firmware project skeleton
    Starting point for the real firmware, separate from peripheral_test's
    bring-up exerciser. Reuses the nanopage board definition and pin
    variant since it's the same hardware.
2026-09-05 feat: Scaffold per-peripheral driver files in nanopage-firmware
    Empty header/source pairs for each on-board peripheral (RTC, fuel gauge,
    charger, buttons, display, microSD, BLE), headers under include/ per
    PlatformIO convention, plus the GxEPD2/SdFat lib_deps they'll need.
2026-09-05 feat: Add header bar with battery/charging indicator to nanopage-firmware
    Implements Display (GxEPD2 + U8g2_for_Adafruit_GFX) and FuelGauge
    (MAX17055) drivers, and a HeaderBar UI module that draws battery level
    and charging status using Siji icon-font glyphs in the top-right
    corner. Also switches the refresh loop to only redraw when the fuel
    gauge state actually changes, using fast partial e-paper updates with
    a full refresh every 8th redraw to clear ghosting.
2026-09-05 feat: Add file browser page mode to nanopage-firmware
    Lists SD card files/folders with siji cursor/folder/file icons, navigable
    via the PREV/NEXT/ACTION buttons, and shows the current folder in the
    header bar. The SD card is only powered on for the duration of a directory
    read. Also fixes a cross-task race between the button interrupt task and
    the main loop's battery poll racing on the shared display/file-browser
    state, and moves tunable timing constants into a new Config.h.
2026-09-05 feat: Add deep-sleep mode to nanopage-firmware
    After 30 minutes of no button activity, draw a moon icon, power down the
    SD card and I2C bus, and put the nRF52 into System OFF. Any button press
    senses a GPIO wake, which is a full reset - execution resumes at setup().
2026-09-05 feat: Add footer bar with battery voltage/current and free-heap debug info
    Redrawn as its own entity, independent of the header - only refreshes
    when its own readings change, at the precision they're displayed at.
2026-09-07 fix: write dQAcc/dPAcc during MAX17055 EZ-Config, improve burn test
    Maxim's EZ-Config sequence (UG6365 3.1) requires dQAcc/dPAcc alongside
    DesignCap/IChgTerm/VEmpty to scale FullCapNom to the pack's capacity;
    leaving them unset likely explains why prior burn-test cycles never
    converged on the right full-charge SOC.
    Also reworks burn_test_main to sample peak current mid SD-hammer
    (instead of only after), stop adding load whenever the charger is
    active, and detect a genuine full charge taper to end the test run
    instead of relying on a fixed low-voltage floor alone.
2026-09-08 feat: persist MAX17055 learned params, move burn test to peripheral_test
    Fuel gauge model state (rcomp0, tempCo, capacity, cycles) only lives in
    the chip's own registers and is lost if the battery is unplugged.
    FuelGauge now supports restoring a saved snapshot instead of always
    running EZ Config from a blank slate, and main.cpp mirrors the learned
    params to internal flash on a timer and before deep sleep. New boards
    with no flash save yet fall back to a FACTORY_SEED captured from a
    calibrated reference board rather than the generic Li-ion model.
    Also moves the burn-test firmware (env:nanopage_burntest) out of
    nanopage-firmware and into peripheral_test as its own build, since it's
    a calibrat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
2026-09-08 fix: replace whole-region partial refresh with exact-widget dirty rects
    Full-region partial refreshes (header strip, footer strip, file-browser
    content block) were leaving stray pixels around custom bitmap glyphs whose
    rendered extent exceeds their reported advance width/height. Narrow each
    refresh down to the widget that actually changed - battery/charging cluster,
    footer stats, footer heap, and cursor-arrow move - with margin sized to
    cover glyph overhang, and redraw neighboring static content (rule lines,
    type icons) that a rounded-up partial window might otherwise whiten without
    repainting.
    Also brings back a periodic full refresh (every 8th partial, shared across
    all four call sites) t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
2026-09-08 feat: drive battery UI off fuel-gauge ALRT and charger STAT instead of polling
    Enables the MAX17055's 1%-SOC-change alert (CONFIG.Aen + CONFIG2.dSOCen) and
    services it via the ALRT interrupt, so the header/footer redraw on real SOC
    changes instead of waiting on a fixed poll; the poll interval becomes a
    30-minute fallback. The charging icon now reads the BQ25170's STAT pin
    directly instead of inferring charge state from fuel-gauge current, which
    lagged real plug/unplug events by several seconds.
2026-09-08 fix: gate Serial.begin() behind DEBUG_SERIAL, not just its wait loop
    With USB CDC always enumerated (Serial.begin() ran unconditionally even
    when DEBUG_SERIAL only gated the wait-for-terminal loop and the prints),
    the panel would garble after roughly every 8-9 refreshes with no terminal
    attached. The always-on background USB activity was contending with the
    e-paper's timing-sensitive SPI transfers and BUSY-pin polling closely
    enough to occasionally corrupt a refresh. Never bringing up USB CDC at all
    in DEBUG_SERIAL=false builds removes that interference.
    Also bumps FULL_REFRESH_EVERY to 15 and records what testing has confirmed
    about panel_.hibernate() needing to run after every refresh, pa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
2026-09-08 fix: rewrite fuel-gauge capacity config every boot, add recal diagnostics
    FuelGauge::begin() left DesignCap/IChgTerm/VEmpty stale whenever the
    restore-learned-params path ran, since restoreLearnedParams() deliberately
    only touches learned model state. Split them into writeCapacityConfig()
    and call it unconditionally in begin() on both nanopage-firmware and
    peripheral_test's copy.
    Add a FORCE_FUELGAUGE_RECAL one-shot config flag plus
    FuelGauge::forceFullReinit()/debugDumpRegisters() to force a fresh
    EZ-Config re-init and dump registers for comparison against datasheet
    values, for recovering a corrupted learned FullCapRep without a physical
    battery disconnect.
    Also in main.cpp: read PIN_CHG_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
2026-09-09 fix: recapture fuel-gauge factory seed from post-fix burn-test cycle
    The 2026-09-08 seed predates the fix that makes DesignCap/IChgTerm get
    rewritten every boot, and may have inherited the same corruption. New
    seed captured 2026-09-09 from a full discharge/charge cycle after that
    fix, with fullCapRep (315.5mAh) close to the 320mAh design capacity and
    MixSOC confirmed in-range. Updates the README to match, including
    pointing at the new debugDumpRegisters() dump instead of manual
    instrumentation.
2026-09-09 fix: work around RAM-layout-sensitive display corruption
    Confirmed on hardware (repro: boot, move the cursor down 11 times) that
    the panel garbles at the first full refresh following a run of partial
    refreshes, and that it's a RAM-layout-sensitive memory corruption, not
    DEBUG_SERIAL/USB-CDC state, SD-card power sequencing, a stack overflow,
    or linked-but-unused flash code - all ruled out by direct A/B test
    against the repro. Reserving 1KB via displayCorruptionWorkaroundPadding
    in Display.cpp prevents it; root cause is still unknown. Also updates
    the DEBUG_SERIAL comment in Config.h to record that unconditionally
    calling Serial.begin() alone did not fix it either.
2026-09-09 feat: decode fuel-gauge register dump to engineering units
    Raw hex values in debugDumpRegisters() were tedious to interpret by hand
    during the ongoing calibration investigation, converting each to mAh, mA,
    V, or percent as appropriate made the live dumps directly readable.
2026-09-09 fix: correct MAX17055 CONFIG register address
    REG_CONFIG was 0x01, which is actually the VAlrtTh (voltage alert
    threshold) register per the MAX17055 datasheet - the real Config
    register (holding the Aen bit that gates the ALRT pin) is at 0x1D.
    The Aen bit position (0x0004) was already correct, just aimed at the
    wrong register, so enableSocChangeAlert() was corrupting VAlrtTh
    every boot instead of enabling the SOC-change alert, and the
    ALRT-driven redraw path likely never fired.
2026-09-09 fix: correct fuel-gauge restore procedure per UG6365
    Two bugs in FuelGauge::restoreLearnedParams()/begin(), found by
    cross-checking against Maxim's MAX17055 Software Implementation Guide
    (UG6365) and full datasheet:
    - Register writes used a bare one-shot writeReg() where UG6365
    mandates write-and-verify (write, delay 1ms, read back, retry up to
    3x) for registers the chip's own ModelGauge algorithm updates on its
    own (FullCapRep, MixCap) - a plain write can lose that race and get
    silently dropped. Added writeAndVerifyReg() and switched every write
    in the restore path to use it.
    - begin() treated "restore learned params" and "run EZ-Config" as
    mutually exclusive, so any POR with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
2026-09-09 fix: port write-and-verify fix to peripheral_test's FuelGauge copy
    Same writeAndVerifyReg() fix as nanopage-firmware's FuelGauge (see
    previous commit) applied to peripheral_test's separate, unshared copy
    used by the battery burn-test tool, for consistency between the two.
    Note: peripheral_test's begin() call site (burn_test_main.cpp) never
    passes a seed, so restoreLearnedParams() - and this fix - is currently
    dead code there. The EZ-Config/restore mutual-exclusivity fix from the
    previous commit was deliberately NOT ported here for the same reason;
    port both if that call site ever starts passing a seed.
2026-09-09 feat: persist fuel-gauge learned params to flash
    Mirrors FuelGauge::learnedParams() to internal flash
    (/fuelgauge_learned.bin, checksummed), saved hourly and before deep
    sleep. On a real POR, seeds the restore with, in priority order: this
    chip/battery's own flash-saved history if present and it passes
    FuelGauge::learnedParamsPlausible(), otherwise FACTORY_SEED for a
    genuinely new/never-saved board. The plausibility check guards against
    a corrupted snapshot being faithfully restored forever - the failure
    mode that caused most of the preceding fuel-gauge debugging saga.
    Also adds a manual wipe path: Config::FORCE_FUELGAUGE_RECAL now also
    deletes the flash snapshot (in addition to its existin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
2026-09-09 feat: add BLE radio load to battery burn test
    Stacks a continuously-advertising BLE radio (max TX power, fastest
    legal legacy advertising interval) on top of the existing SD/e-paper
    hammering, gated by the same shouldLoad condition (paused whenever
    charging, depleted, or cycle-complete) so it doesn't fight the
    charger's own taper detection any more than the existing load does.
    Also doubles the SD write-chunk count per iteration (~1MB -> ~2MB) to
    spend more time in the actual high-current write/read phase relative
    to file open/close overhead, and bumps the SD SPI clock 4MHz -> 16MHz
    (within the card's 25MHz default-speed spec) to keep the flash
    controller busier for more sustained current dr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
2026-09-09 docs: add MAX17055 datasheet and software implementation guide
    Reference material used throughout the fuel-gauge restore-procedure
    debugging in the preceding commits (Maxim's UG6365 and the full
    MAX17055 datasheet).
2026-09-09 fix: enforce a minimum gap between panel hibernate() and the next refresh
    The e-paper panel garbled at the first full refresh following a run of
    partial refreshes (repro: boot, move the file-browser cursor down 11
    times). Previously chased as RAM-layout-sensitive corruption and
    "mitigated" with a padding array whose effect had stopped working.
    Isolated instead to a timing margin: starting a refresh too soon after
    panel_.hibernate() reproduces it, and a few milliseconds of any delay
    avoids it - incidental Serial.print time on the refresh path was
    masking it, which is what pointed at timing instead of memory.
    Display::waitForMinRefreshGap() now enforces MIN_REFRESH_GAP_MS (30ms)
    between the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
2026-09-09 docs: correct Display.h comment - padding array is still required too
    Tested removing displayCorruptionWorkaroundPadding with the min-refresh-
    gap fix already in place: the same corruption came straight back. The
    comment this amends (from the previous commit) assumed the timing fix
    had superseded the padding mitigation - it hadn't. Both are load-bearing
    together, for reasons not yet understood.
2026-09-10 docs: track PDF datasheets with Git LFS
    Adds new component datasheets and moves all docs/*.pdf files to LFS
    to keep the repo lightweight.
2026-09-10 feat: scaffold nanopage Zephyr board and first custom build
    Adds a custom out-of-tree board (Firmware/boards/nanopage/nanopage/)
    generated from the README pin table: shared SPI3 bus for the display
    and SD card, shared I2C1 bus for the RTC and fuel gauge, buttons on
    gpio-keys, and the NFC-pin GPIO fix (P0.09/P0.10 default to NFC
    antenna mode on the nRF52840, switched via &uicr nfct-pins-as-gpios).
    Flash runner is OpenOCD only, targeting the Raspberry Pi Debug Probe
    directly since there's no bootloader yet.
    Verified end-to-end on hardware: west build + west flash over SWD,
    with RTT console readback confirming the app boots and runs.
2026-09-10 feat: bring up RTC and buttons on nanopage board
    Wire the PCF85063 RTC (nxp,pcf85063a in-tree driver) into the board
    devicetree and seed/read it each second; buttons were already wired,
    just untested until now. Verified end-to-end on hardware over RTT
    (RTC ticking, all three button press/release events).
    Split main.c into src/rtc.c + src/buttons.c so app logic stays out of
    main, following Zephyr's convention of keeping private per-module
    headers alongside their .c file in src/.
2026-09-10 feat: bring up SSD1680 e-paper display with full/fast/partial refresh
    Wires the GDEY029T94 panel on spi3 via a zephyr,mipi-dbi-spi bridge and
    the in-tree solomon,ssd1680 driver, and adds app-level helpers
    (Firmware/src/display.c/.h) for all three SSD1680 refresh modes: a
    forced full (ghost-free) refresh, a fast whole-screen refresh, and a
    partial-rectangle refresh - the latter two share the same OTP-stored
    waveform, enabled by an empty devicetree "partial" profile node.
2026-09-10 feat: add text-grid UI layer with partial-refresh cursor support
    Adds text.c/text.h: a fixed rows/cols character-grid renderer built
    directly on display.c, reusing Zephyr's built-in CFB font tables
    without pulling in the CFB subsystem itself (its finalize() can't do
    partial-region writes and its framebuffer state isn't accessible).
    Tracks per-row dirty column ranges so a cursor move or single text row
    change flushes as one small partial refresh instead of a full repaint,
    with periodic full refreshes still available to clear ghosting.
    Also fixes two bugs found along the way (neither visible during the
    earlier display.c bring-up, which only ever tested uniform fills):
    the refresh buffer is ac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
2026-09-11 feat: bring up MAX17055 fuel gauge with POR-gated learned-parameter restore
    From-scratch driver (src/max17055.c/.h) rather than Zephyr's in-tree
    maxim,max17055 one - that driver's init() runs automatically at POST_KERNEL
    and unconditionally EZ-configures on every POR, with no hook to check flash
    for previously-learned impedance-track parameters first. Split into a
    mechanism layer (max17055.c: register I/O, no automatic configuration) and
    a policy layer (fuel_gauge.c: POR handling, NVS save/restore of learned
    parameters on the existing storage partition, compiled-in factory-default
    fallback for new boards). Devicetree config values (Rsense, charge current,
    charge voltage) are pulled from the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
2026-09-11 feat: add System OFF power state with GPIO-wake and EPD deep sleep
    Idle timeout (30 min, reset on any button press) drops the nRF52840
    into System OFF, the lowest power state available with no bootloader/
    RAM retention. Wake is armed via GPIO_INT_LEVEL_ACTIVE on the three UI
    buttons right before sys_poweroff(), matching the in-tree
    system_off sample's approach. Reset cause is read directly from
    NRF_POWER->RESETREAS (hwinfo doesn't build for plain nRF52840 in this
    Zephyr version) to show a "Waking up..." message on a System OFF wake.
    Also puts the SSD1680 into its own Deep Sleep Mode 2 before power-off
    (~20uA resting current down to ~0.7uA) by talking to it directly over
    MIPI DBI, since the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
2026-09-11 fix: pull down SPI3 MISO to eliminate a genuinely floating shared input
    MISO is shared between the display and SD card on spi3, and neither
    slave drives it while its own CS is deasserted - confirmed via a live
    PIN_CNF register scan that it sits as a connected, unpulled input
    whenever the bus is idle, which is most of the time. Split it into its
    own pinctrl group (default and sleep) with bias-pull-down so it always
    has a defined level.
    Tested against the open ~1-2.5mA idle-current investigation as the
    most promising untested lead, but AvgCurrent read the same after the
    fix as before - ruled out as the/a dominant cause. Keeping the pull
    down anyway since a floating shared-bus input is bad pra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
2026-09-11 feat: add siji icon font for cursor/folder/file/battery glyphs
    Ports the same 13 glyphs the old (abandoned) Arduino/GxEPD2 firmware
    used via u8g2 (cursor, folder, file, charging bolt, 9 battery fill
    levels) straight from siji's own upstream BDF, using the same
    BDF -> CFB_FONT_MONO_VPACKED pipeline built for the Tamzen font.
    siji's real codepoints are scattered Unicode Private Use Area values,
    not useful as a contiguous first_char/last_char range for text.c's
    font model, so they're remapped to a small local enum app_text_icon
    (0..12) instead. Icons aren't part of the character grid the way text
    is - added as app_text_draw_icon(row, x, icon), a pixel-x sibling to
    the existing column-based app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
2026-09-12 fix: clear MAX17055 ETHRM bit and record current-leak investigation
    THRM is unconnected on this board, but ETHRM defaults to 1 at POR
    regardless of TSel, so the chip periodically biases an open pin.
    Also adds the full schematic PDF and updates project memory with the
    sleep-current leak investigation (R5/USB_DETECT contributor found,
    several hypotheses ruled out, PPK2 measurement still pending).
2026-09-12 fix: bump R5 (USB_DETECT) pull-up to 931k, cutting a confirmed 330uA leak
    Direct multimeter ammeter measurement (not the fuel gauge) put the
    true idle draw at 880uA on a battery without a protection circuit,
    confirming R5's TPS2116 ST pull-up as a real, continuous ~330uA path.
    Reworked 10k -> 931k in the same 0402 footprint (drop-in bench
    rework), checked safe against the TPS2116's leakage/VOL/response-time
    specs - expected new draw ~3.5uA, not yet re-verified on hardware.
    Also records this session's fuel-gauge-vs-multimeter comparison
    (AvgCurrent tracks closely; raw Current reads 5-24% high and noisier -
    R11's tolerance and the multimeter's own accuracy spec were both
    checked and ruled out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
2026-09-13 feat: show instantaneous + average current on status bar
    Instantaneous Current is sampled 5s before the periodic refresh
    instead of right at refresh time, so the reading isn't skewed by the
    SSD1680 partial-refresh SPI burst that follows immediately after.
    AvgCurrent stays chip-filtered and read at refresh time as before.
2026-09-13 refactor: organize Firmware/src into display/power/drivers subfolders
    Group display+text+font files under src/display, fuel-gauge+power under
    src/power, and rtc/buttons under src/drivers. main.c stays at the top
    level. CMakeLists.txt updated with new source paths and per-folder
    include dirs so cross-folder #includes keep resolving unchanged.
2026-09-13 feat: add header bar UI, drive charging from BQ25170 STAT, event-driven updates
    Header bar (row 0): folder placeholder, centered dd/mm/yy HH:mm clock,
    and a right-aligned charging/percentage/battery-icon cluster, with a
    separator rule sharing the row's own dirty-tracking. UI-rendering layer
    (text.c, fonts, new header.c/footer.c) moved into its own src/ui folder,
    separate from the raw SSD1680 driver in src/display. The old status bar
    becomes footer.c, bottom-aligned in its cell via a new
    app_text_draw_row_bottom_aligned() so it sits flush against the panel's
    physical edge instead of leaving Tamzen's bottom-padding gap visible.
    Charging state now comes from the BQ25170's own STAT output (P0.0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
2026-09-13 fix: force fuel gauge to 100% on confirmed charge completion
    RepSOC (RepCap/FullCapRep) only auto-corrects to 100% once it crosses
    the MAX17055's FullSOCthr gate (POR default ~95%), which this board's
    Option-2 "Custom Short INI" configure sequence never writes. On a
    battery whose impedance-track model hasn't converged yet, RepSOC can
    plateau below that gate even after a real charge finishes, so it never
    snaps up (observed stuck at 68%).
    Use the BQ25170 STAT pin as ground truth instead: on a charging->not-
    charging transition, if cell voltage confirms the CV-taper actually
    completed (vs. USB just being unplugged mid-charge - both give the
    same STAT transition), manually set FullCapRep = RepC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
2026-09-13 refactor: drop per-refresh timing instrumentation from display.c
    log_elapsed() was bring-up diagnostics for measuring full/fast/partial
    refresh durations (already recorded in .claude/CLAUDE.md); no longer
    needed now that the display driver is stable production code.
2026-09-13 feat: add microSD card support with SPI3 bus-sharing power fix
    Adds FAT/SDHC-SPI storage support (storage/sd.c) and reference-counted
    SD power control bracketed around every display refresh, needed because
    the SD card and e-paper display share spi3 with no bus isolation - an
    unpowered card corrupts display traffic and its CS line backfeeds its
    own VDD rail while idle. app_sd_power_off() forces CS low before
    cutting power to eliminate the idle backfeed/leak; display.c takes a
    matching SD power hold around every refresh to eliminate corruption
    during active bus traffic. Also fixes a stack overflow in fs_mount()
    via a larger main thread stack.
2026-09-13 docs: note to use separate SPI buses for SD card and EPD next design
    Sharing one SPI bus between the two, gated only by a power switch on
    the SD card, causes the EPD to misbehave whenever SD power is cut -
    see the firmware-side writeup in .claude/CLAUDE.md for the full
    root cause.
2026-09-13 feat: add SD card file browser UI with icon-based folder/file listing
    Prev/Next move the selection cursor, Action opens a folder (or goes up
    via a synthetic ".." entry) - directories-first alphabetical listing,
    folder/file/cursor siji icons. sd.c gains app_sd_list_dir() (mechanism
    only, no mount/power handling of its own - see sd.h) for browser.c's
    policy layer to build on. buttons.c/.h grows a proper press-callback
    API (enum app_button) instead of just logging, and header.c now folds
    the real current path into its redraw change-check.
    text.c's app_text_flush() coalesces adjacent dirty rows into one
    combined SSD1680 partial refresh instead of one per row - without
    this, a two-row cursor mov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
2026-09-13 feat: add .npb book format spec and EPUB converter
    Custom low-power ebook format (.npb) replacing EPUB on-device: word-wrapping
    happens once offline per font size, so the reader just indexes a row table
    instead of parsing HTML/reflowing text. Adds the on-disk struct definitions
    (Firmware/src/book/npb_format.h, npb_bookmark_format.h) and a PC-side Python
    converter (Converter/) that unzips an EPUB, extracts paragraphs and chapter
    markers, transliterates to 7-bit ASCII, and pre-wraps the shared text blob
    for all three Tamzen font sizes. Also adds `just book-setup`/`book-convert`
    recipes for running it.
2026-09-13 feat: add on-device book reader with per-screen font sizing
    Opens a .npb file selected in the browser into a new reader screen
    (src/ui/reader.c, mechanism split into src/book/npb.c): Prev/Next turn
    pages, Action closes back to the browser, and the current position
    auto-resumes from a .npb.bmk sidecar. Book content renders in its own
    font, independent of the header/footer/browser's font - text.c gained
    band-granularity dirty tracking and a pixel-addressed draw primitive
    (app_text_draw_text_px) to let a taller font's rows coexist with the
    existing 16px chrome rows. Added the two larger Tamzen sizes
    (8x16/10x24, converted from upstream BDF and verified pixel-for-pixel
    before flashing) alongside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
2026-09-13 refactor: centralize tunable constants into config.h
    Timers, intervals, and thresholds scattered across main.c, power.c,
    fuel_gauge.c, sd.c, browser.c, and reader.c now live in one
    Firmware/src/config.h, so a battery-life/UX tuning pass touches one
    file instead of hunting through every subsystem.
2026-09-14 feat: log fuel-gauge current/voltage samples to SD card
    Adds currentlog.c/.h, writing a CSV row (timestamp, instant/avg
    current, voltage) on every status-bar tick, for offline analysis of
    the ongoing idle-current investigation. Reuses the exact reading
    footer.c already samples/draws each tick (app_footer_get_last())
    rather than a redundant I2C read. Needed a sortable ISO timestamp
    (app_rtc_format_datetime_iso()) alongside rtc.c's existing
    display-oriented formatters, and a longer current-sample lead time
    (config.h, 5s -> 10s) to keep the sample further from the write's own
    SPI activity.
2026-09-14 fix: power microSD card on-demand instead of holding it mounted always
    main.c mounted the card once at boot (via app_browser_init()) and
    never released it, so the SD load switch stayed powered for the
    entire session regardless of whether the card was actually being
    touched - browsing, reading, or otherwise idle. Combined with the new
    per-tick current logger, this meant the card was effectively always
    on.
    Moves every SD access to its own app_sd_init()/app_sd_deinit()
    bracket instead of one long-lived hold:
    - browser.c: load_dir() brackets each directory listing (initial load
    and every folder navigation), rather than app_browser_init() holding
    the mount for the browser's whole lifetime.
    -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
2026-09-14 fix: use SSD1680 Deep Sleep Mode 1 instead of Mode 2, wait for BUSY after refresh
    Mode 2 doesn't reliably come back from a real System OFF wake on this
    hardware (wake-time refresh silently corrupted), despite the datasheet
    describing both modes identically. Also make refresh functions block
    until BUSY clears before returning, since display_blanking_off()/
    display_write() return immediately while the panel keeps updating in
    the background - needed so the SD power bracket doesn't cut power
    mid-refresh.
2026-09-14 docs: record PPK2 current-leak investigation findings; tune idle timeout
    Documents the display-driver-vs-BUSY-pull-level bisection that traced
    the ~600uA idle current to BUSY's static DC level, plus dead ends
    ruled out along the way. Also drops the System OFF idle timeout to
    10 minutes.
2026-09-17 fix: suspend spi3 explicitly instead of relying on PM_DEVICE_RUNTIME
    CONFIG_PM_DEVICE_RUNTIME's automatic suspend cleared SPIM3->ENABLE but
    never actually released whatever was keeping spi3 costing real current
    (idle ~880-930uA), even though register-level checks looked correct -
    the root cause of the weeks-long power investigation in CLAUDE.md.
    Found by comparing against a parallel from-scratch firmware rewrite
    that avoided CONFIG_PM_DEVICE_RUNTIME and called
    pm_device_action_run() explicitly around spi3 instead.
    Dropped CONFIG_PM_DEVICE_RUNTIME/CONFIG_PM_DEVICE_RUNTIME_DEFAULT_ENABLE
    and wrapped app_display_lock()/app_display_unlock() with explicit
    resume/suspend, covering every refresh a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
2026-09-18 fix: switch fuel_gauge.c to non-deprecated NVS header/macros
    zephyr/fs/nvs.h and FIXED_PARTITION_DEVICE/OFFSET/SIZE were deprecated
    in the Zephyr 4.4.0 upgrade in favor of zephyr/kvss/nvs.h and
    PARTITION_DEVICE/OFFSET/SIZE, silencing the resulting build warnings.
2026-09-18 feat: add USB Mass Storage so the SD card shows up as a USB drive
    Exposes the microSD card over USB (Zephyr's newer USB device stack +
    USBD_MSC_CLASS) whenever a host is connected, so books can be dragged
    onto it without pulling the card. Takes over button input with a
    "connected" screen while active, blocks System OFF for the duration,
    and hands the card back to the file browser on disconnect.
    Two real bugs found and fixed while bringing this up on real hardware:
    - display.c's spi3 PM resume/suspend was unconditional (never needed
    refcounting before, since every prior caller finished one bracketed
    operation per lock/unlock pair) - the periodic status-bar refresh was
    suspending spi3 m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
2026-09-18 fix: only claim USB MSC session on real enumeration, not bare VBUS
    VBUS just means "5V present" - true for a dumb charger exactly as much
    as a real computer, since a charger never speaks USB protocol at all.
    Claiming the SD card/screen/buttons on VBUS_READY meant a charger-only
    connection incorrectly showed "Connected to computer".
    VBUS_READY now only attaches to the bus (usbd_enable, the D+ pull-up),
    which is needed either way so a real host can enumerate us. The actual
    session claim moves to USBD_MSG_CONFIGURATION with a nonzero value - a
    message that only fires once a real host completes SET_CONFIGURATION,
    which a charger can never send. SET_CONFIGURATION(0) (deconfigure) is
    routed throu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
2026-09-18 fix: power SD card around the display driver's own boot-time refresh
    ssd16xx_init() does a real hardware reset + full refresh automatically
    at POST_KERNEL, before main() ever runs - the one refresh in the
    codebase that wasn't behind app_display_lock()'s SD-power bracket.
    With a card inserted, this backfed into its unpowered rail and
    corrupted the screen on every flash, only clearing on a real battery
    power cycle. Bracket it with two SYS_INIT hooks in sd.c instead.
2026-09-18 fix: suspend i2c1 explicitly instead of leaving TWIM1 always-on
    spi3 got explicit pm_device_action_run() resume/suspend calls when
    CONFIG_PM_DEVICE_RUNTIME was dropped project-wide, but i2c1 (RTC +
    fuel gauge) never did - it was just left in the ACTIVE state
    pm_device_driver_init() puts it in at boot, with no code path ever
    suspending it again. Add a small refcounted app_i2c1_lock()/
    app_i2c1_unlock() (i2c1_bus.c/.h) mirroring display.c's spi3
    handling, and wrap every rtc.c/max17055.c function that actually
    issues an i2c1 transaction with it.
    No leak was ever measured on i2c1 - this closes a known
    consistency gap, not a chased regression.
2026-09-18 feat: add app menu with File Browser and Settings apps
    The device now boots into a small app menu (menu.c/.h) instead of
    straight into the file browser, which is just one of the apps listed
    there now. Settings (settings.c/.h, new) wires up app_reader_set_font()'s
    long-unused "future settings menu" hook into a real text-size picker.
    browser.c gained a way back to the menu: the synthetic ".." entry at the
    SD root now calls an on_exit callback instead of being a dead end.
    app_browser_reinit() covers usb_msc.c's post-disconnect re-list without
    disturbing that callback.
    usb_msc.c's release_session() used to always jump back into the file
    browser after a disconnect - fixed to check whether the b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
2026-09-18 fix: drive idle-timeout System OFF off a rescheduled work item
    app_power_check_idle() was only ever evaluated from the footer's 30s
    periodic tick, so System OFF entry lagged the configured
    APP_POWER_IDLE_TIMEOUT_MS by up to one tick plus boot overhead.
    Replaced with idle_work, a k_work_delayable rescheduled to fire
    exactly APP_POWER_IDLE_TIMEOUT_MS out on every
    app_power_mark_activity() call, backed by the same LFXO already
    clocking tickless idle.
    app_power_set_sleep_inhibited(true) now cancels the pending timer
    outright instead of gating a poll, and app_power_mark_activity()
    itself refuses to re-arm while inhibited, since buttons.c calls it
    unconditionally on every press even during an act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
2026-09-18 feat: add chapter navigation via a long-press in-book menu
    Prev/Next/Action are already fully committed to paging/closing while a
    book is open, so a long-press on Action (Zephyr's in-tree
    zephyr,input-longpress pseudo-device, no hand-rolled hold-timing)
    opens a new in-book menu instead of needing a fourth button. The menu
    offers Table of Contents (jumps to any chapter via the book's existing
    npb_find_row() binary search) and a reserved, still-inert Bookmarks
    entry.
    Fixes a bug found during hardware testing where returning from the
    menu/TOC left the screen showing stale content until a second button
    press: reopen_reading() was missing the app_sd_init()/app_sd_deinit()
    bracket every other ren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
2026-09-18 feat: move bookmark sidecars into a hidden .nanopage folder
    Sidecars (<book>.npb.bmk) now live in a hidden ".nanopage" subfolder
    next to each book instead of directly alongside it, so they no longer
    need to be filtered out of the file browser's listing by extension -
    app_sd_list_dir() already skips dot-prefixed entries on its own.
2026-09-18 feat: add explicit bookmark slots with a Prev+Action combo gesture
    Holding Prev and Action together toggles a bookmark at the current
    page (buttons.c gains chord-detection support), shown as a small
    ribbon icon in place of the header's folder name. The in-book menu's
    previously-inert "Bookmarks" entry now opens a real list screen
    showing each bookmark's chapter and page number and jumping to it on
    selection. Also fixes "Back" inside the Table of Contents/Bookmarks
    screens, which used to skip past the in-book menu straight to the
    page - it now returns to the menu instead, matching "Back to Book".
2026-09-19 feat: flush reader state and resume into the book on an idle wake
    power.c's idle timeout previously unmounted the SD card and cut display
    power unconditionally, with no way for reader.c to react first. Add
    app_power_set_idle_hook() so a screen can flush anything not already
    persisted before that happens - reader.c uses it to catch
    app_reader_set_font()'s lazily-saved position/font choice, and to leave a
    resume marker on the SD card. A System-OFF wake now reopens straight back
    into that book (main.c, via app_power_woke_from_system_off()) instead of
    landing on the app menu.
    Also bumps CONFIG_MAIN_STACK_SIZE 2048->4096: the resume path is the first
    time app_reader_open()'s full call chain runs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
2026-09-20 perf: stop reader from reopening the book to save bookmarks
    save_bookmark() reopened the .npb file on every call just to recompute
    the blob offset that render_page() (and toggle_bookmark()) had already
    computed moments earlier. That's a redundant FAT lookup + header read
    + variant-table scan over SD/SPI on the hottest path in the app (every
    page turn).
    Cache the offset (last_blob_offset) as it's produced by render_page(),
    toggle_bookmark(), and app_reader_jump_to_offset(), and have
    save_bookmark() consume the cached value and the already-populated
    book.font_id instead of reopening the book.
2026-09-20 perf: share one SD mount across a burst of reader actions
    Reader actions (page turns, bookmark toggles, TOC jumps, font switches)
    each fully mounted and unmounted the SD card, paying the power-up
    settle delay and FAT mount cost every single time. Tried holding the
    mount for the whole reading session, but this card draws real current
    just from being powered - measured a 47uA -> 1.5mA regression on the
    PPK2, so that approach is out.
    Instead, hold the mount for a short 2s grace window after the last SD
    touch: closely-spaced actions (rapid page flips, browsing TOC/
    bookmarks) now share one mount, while normal reading pace falls back
    to fully powered-off between actions same as before. Confirmed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
2026-09-20 perf: avoid full fuel-gauge register burst for single-field reads
    footer's current sample (every 20s) and the header's percent readout
    (every minute) each pulled all 16 MAX17055 registers over I2C just to
    use one field. Add single-register reads for current and SOC and use
    them on those hot paths; the footer's full status line still needs
    the multi-field snapshot.
2026-09-20 perf: remove diagnostic current-logging SD power-cycle
    footer_draw_handler() was powering on the SD card, mounting it,
    appending a CSV line, and powering it back off every 30s regardless
    of reader state, purely to maintain currentlog.csv. Drop the feature
    entirely along with the footer plumbing that existed only to feed it.
2026-09-20 perf: share one SD power-up across a multi-region text flush
    app_text_flush() looped over disjoint dirty band-runs, and each call
    to app_display_refresh_partial() took its own app_display_lock()/
    unlock(), power-cycling the SD card (with its 20ms settle delay)
    once per run instead of once per flush. Bracket the whole loop in a
    single lock/unlock pair so a redraw touching multiple non-contiguous
    regions shares one SD power-up.
2026-09-20 perf: remove unconditional printk on every button edge
    button_event_cb() ran in the shared latency-sensitive input path that
    also drives page-turn and SD-touching callbacks; the debug log wasn't
    needed and added overhead on every press/release.
2026-09-20 fix: unwind display lock and SD power on app_sd_usb_claim() failure
    app_sd_usb_claim() locked display_bus_lock and set sd_usb_claimed
    unconditionally before attempting SD power-on/disk_access_init. Either
    failing left the mutex held forever (freezing all future display
    refreshes) and sd_usb_claimed stuck true (permanently blocking
    app_sd_init()). Now each step only commits state after it succeeds,
    and every failure path unwinds what it already did.
2026-09-20 fix: skip footer redraw while a USB-MSC session holds the display lock
    footer_draw_handler() unconditionally called app_footer_draw()/
    app_text_flush(), which blocks on display_bus_lock for the entire
    USB-MSC session (app_sd_usb_claim() holds it until unplug). That
    stalled the system workqueue for every other work item queued on it
    (RTC header updates, etc.) for the duration of the session. Skip the
    draw+flush while app_usb_msc_is_active(); fuel-gauge learned-param
    saving and the sample/draw reschedule loop are unaffected.
2026-09-20 fix: always turn off panel blanking after a full refresh write
    app_display_refresh_full() returned early on a failed display_write(),
    skipping display_blanking_off(). A transient SPI fault during a full
    refresh (boot draw, pre-System-OFF) would leave the panel blanked
    until some later full refresh happened to succeed. Blanking is now
    always turned off before returning; the write's error code still
    takes priority in the return value.
2026-09-20 fix: synchronize idle-timeout System OFF path with close_reader()
    power.c's idle_work_handler() (system workqueue) and reader.c's
    close_reader() (input thread via button callback) both read/write the
    same unsynchronized globals (book, bmk_state, book_open, full_path_buf,
    exit_cb) with no mutex. app_power_mark_activity()'s reschedule can't
    stop an idle-timeout run that's already executing, so an ACTION press
    landing at nearly the same instant as the 5-minute idle timer could
    interleave writes and corrupt the bookmark file.
    Add app_power_cancel_idle_sync(), which cancels the idle work and
    blocks until any in-flight run has finished, and call it at the top of
    close_reader() before touching any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
2026-09-20 fix: treat non-ENODATA RTC read errors as real failures in app_rtc_init()
    Previously any rtc_get_time() error other than -ENODATA fell through to
    the same success path as a valid read, so a transient I2C glitch at boot
    left the system trusting an uninitialized/garbage RTC value with no
    retry, fallback, or diagnostic. Now only -ENODATA (genuinely unset RTC)
    triggers the fallback time-set; any other error is logged and returned
    to the caller.
2026-09-20 refactor: unify book-open/close and give-up teardown shapes in reader.c
    open_book_at_font() validates grid/font metrics (which don't touch
    `book`) before calling npb_open(), so it now has a single npb_close()
    instead of one duplicated across every early-error return.
    Added teardown_reader_hooks() to share the "disable all reader
    input/power hooks and mark closed" shape between close_reader() and
    app_reader_set_font()'s revert-failed fallback, which previously
    hand-rolled the same resets in a different order.
2026-09-20 fix: round battery percentage to nearest integer in header
    soc_x10/10 truncated instead of rounding, so 99.6% displayed as 99%.
    Footer keeps the raw one-decimal value from the fuel gauge; only the
    header's whole-percent display rounds.
2026-09-20 fix: guard setup_usbd() against re-entry instead of a no-op rollback
    usbd_add_configuration()/usbd_register_all_classes() have no "remove"
    counterpart in Zephyr's USBD API (confirmed against Zephyr's own
    sample_usbd_init.c, which has the same gap), so a failed setup_usbd()
    can't be fully unwound. A retry would silently double-register
    whatever already succeeded. Add a static "already attempted" guard so
    a future retry fails loudly with -EALREADY instead of corrupting the
    USBD context's internal lists.
2026-09-20 fix: gate fuel gauge capacity restore on full_cap_nom, not cycles
    cycles==0 only worked as a "no saved data" sentinel because the save
    trigger (bit 6 of the Cycles register toggling) happens to guarantee
    cycles>=64 at every real save today. full_cap_nom is the field the
    restore path actually depends on, so use that as the validity check
    instead of relying on an incidental coupling with unrelated save-
    trigger logic.
2026-10-13 feat: replace siji icons with hand-drawn Phosphor fill icons
    All UI icons are now 1-bit bitmaps drawn after the Phosphor Icons "-fill"
    variants (MIT): cursor, folder, file, settings (faders), bookmark, calendar
    and book. font_siji is renamed font_icons.
    The battery gets its own 18x16 icon font (font_battery) with five fill
    levels and a charging glyph, drawn via app_text_draw_battery(). The header
    shows the charging glyph in place of the battery while charging instead of
    a separate bolt next to it, and the percentage sits closer to the battery.
    The file browser shows the book icon for .npb files and the generic file
    icon for everything else.
2026-10-13 feat: add BLE companion link with phone-connected header icon
    Peripheral-only GATT service (src/ble) with LE Secure Connections passkey
    pairing and bonding stored in a new settings partition. The radio is only
    up while companion mode is active. A 'Connect to phone' menu entry shows
    the advertising/pairing/connected state; once connected the screen returns
    to the menu and the link stays up in the background, and a Bluetooth icon
    appears next to the battery percentage in the header.
    bt_enable() failures are remembered, since Zephyr leaves its enabled flag
    set and a retry would otherwise hang on a controller that never opened.
2026-10-13 feat: add BLE library service (LIST, CHAPTERS) for the companion link
    Scans the SD card for .npb books on a dedicated worker thread and streams
    BOOK/CHAPTER frames over LIB_DATA, with last_position read from the bookmark
    sidecar. Answers storage busy while USB mass storage owns the card. DELETE is
    stubbed until the next step.
2026-10-13 feat: report SD free/total space in companion DEVICE_INFO
    Cache the usage after each library request, while the card is already
    mounted, so the BT-thread read never touches the SD bus.
2026-10-14 feat: vendor the SSD1680 driver to skip its boot-time panel refresh
    Upstream ssd16xx_controller_init() ends with an update_display(), which
    flashes the panel white on every boot. Waking from System OFF is a full
    reset, so that wiped the sleep screen and the app then did its own full
    refresh: two flashes on wake.
    Use a local SSD1680-only copy of the driver (nanopage,ssd1680 compatible,
    same pattern as the MAX17055 driver) without that final update.
2026-10-14 refactor: remove battery/current readout from footer, keep the blank row for future hints
2026-10-14 feat: Add dimensions to board
2026-10-14 feat: vendor custom KiCad symbols, footprints and 3D models into the project
    Move all downloaded and self-made parts into a project-local NanoPage
    library (libraries/NanoPage.{kicad_sym,pretty,3dshapes}) referenced via
    ${KIPRJMOD}, so the design opens on any machine without the global
    external_libraries folder. KiCad built-in parts are unchanged.
2026-10-15 feat: add parametric FreeCAD case design with spec, STEP/STL outputs and previews
